Teruru-52/Cubli/pcb/dxf/main_board.dxf

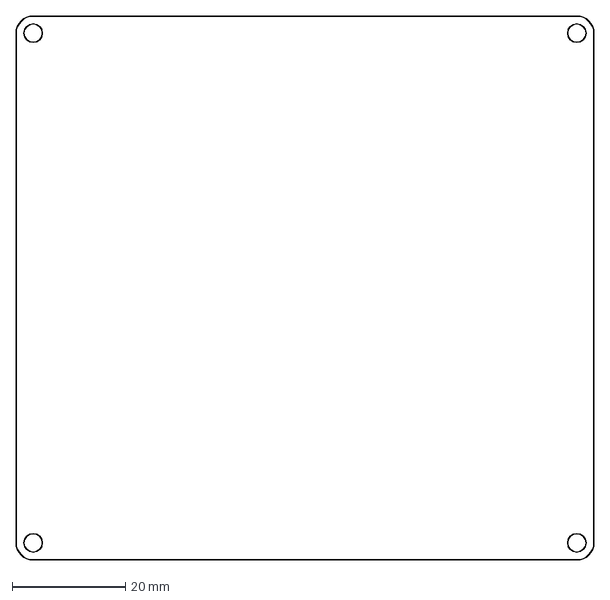
[picture p1: CAD file, 2023-10-04]
pcb/dxf/main_board.dxf
102.0 x 96.0 mm
