Teruru-52/Cubli/pcb/dxf/main_board2.dxf

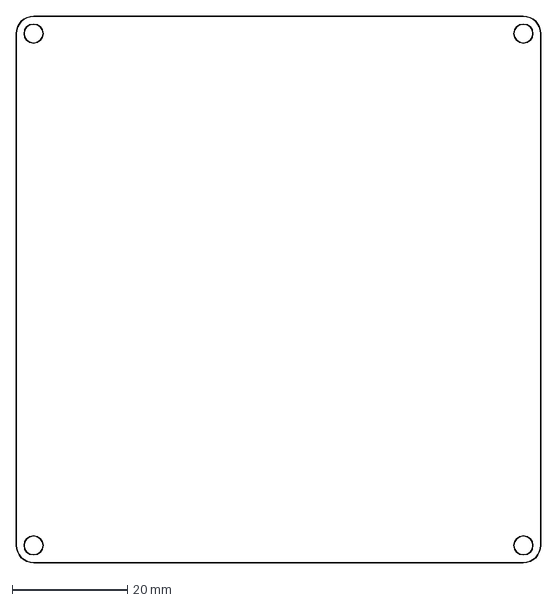
[picture p2: CAD file, 2023-10-04]
pcb/dxf/main_board2.dxf
91.0 x 94.8 mm
