Teruru-52/Cubli/pcb/dxf/lcd.dxf

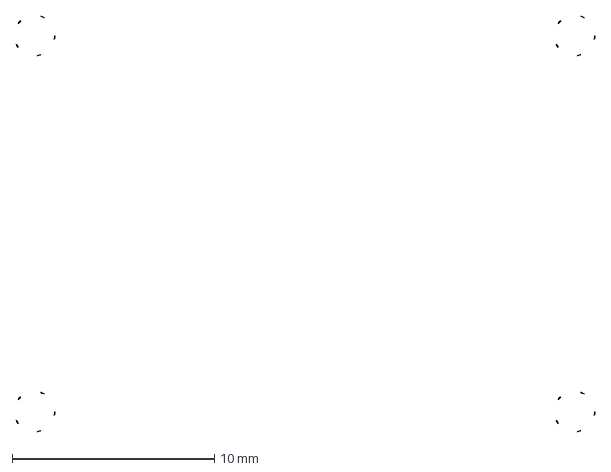
[picture p3: CAD file, 2023-10-04]
pcb/dxf/lcd.dxf
28.6 x 20.5 mm
