Teruru-52/Cubli/pcb/dxf/pdb.dxf

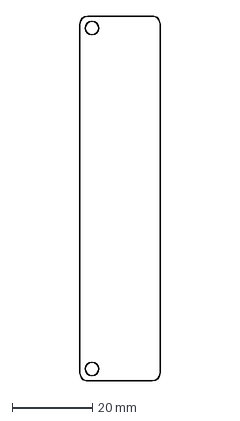
[picture p4: CAD file, 2023-10-04]
pcb/dxf/pdb.dxf
20.0 x 91.0 mm
