Teruru-52/Cubli/pcb/dxf/blmd2.dxf

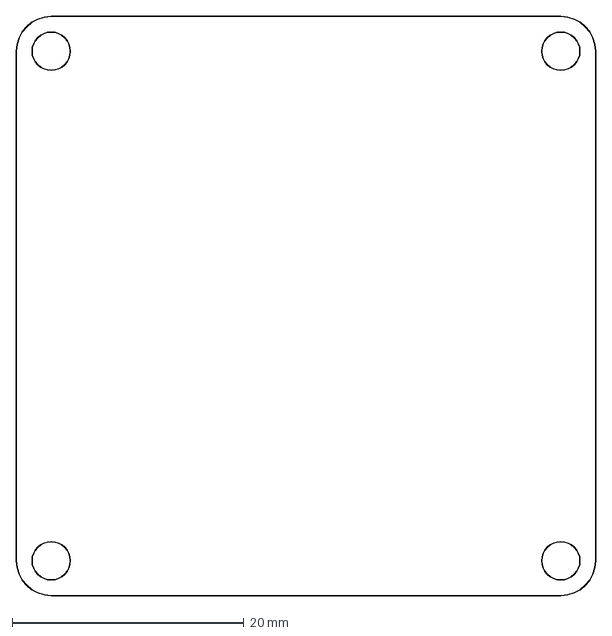
[picture p5: CAD file, 2023-08-15]
pcb/dxf/blmd2.dxf
50.0 x 50.0 mm
