Teruru-52/Cubli/pcb/dxf/blmd.dxf

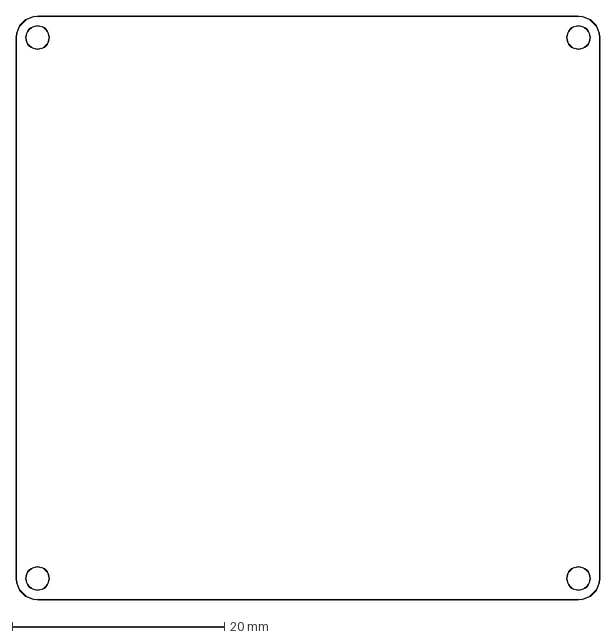
[picture p6: CAD file, 2023-08-14]
pcb/dxf/blmd.dxf
55.0 x 55.0 mm
