Teruru-52/Cubli/pcb/dxf/imu_board.dxf

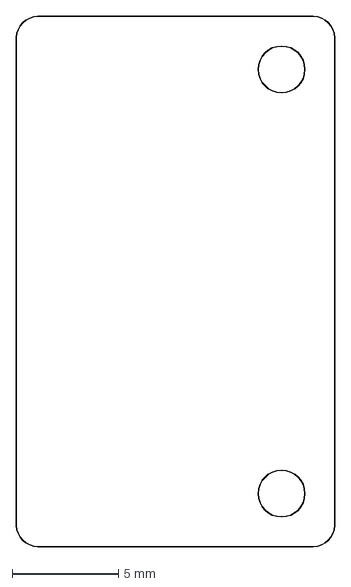
[picture p7: CAD file, 2023-08-14]
pcb/dxf/imu_board.dxf
15.0 x 25.0 mm
