Teruru-52/Cubli/pcb/motor_driver/v1.1/motor_driver-drv8323.pdf

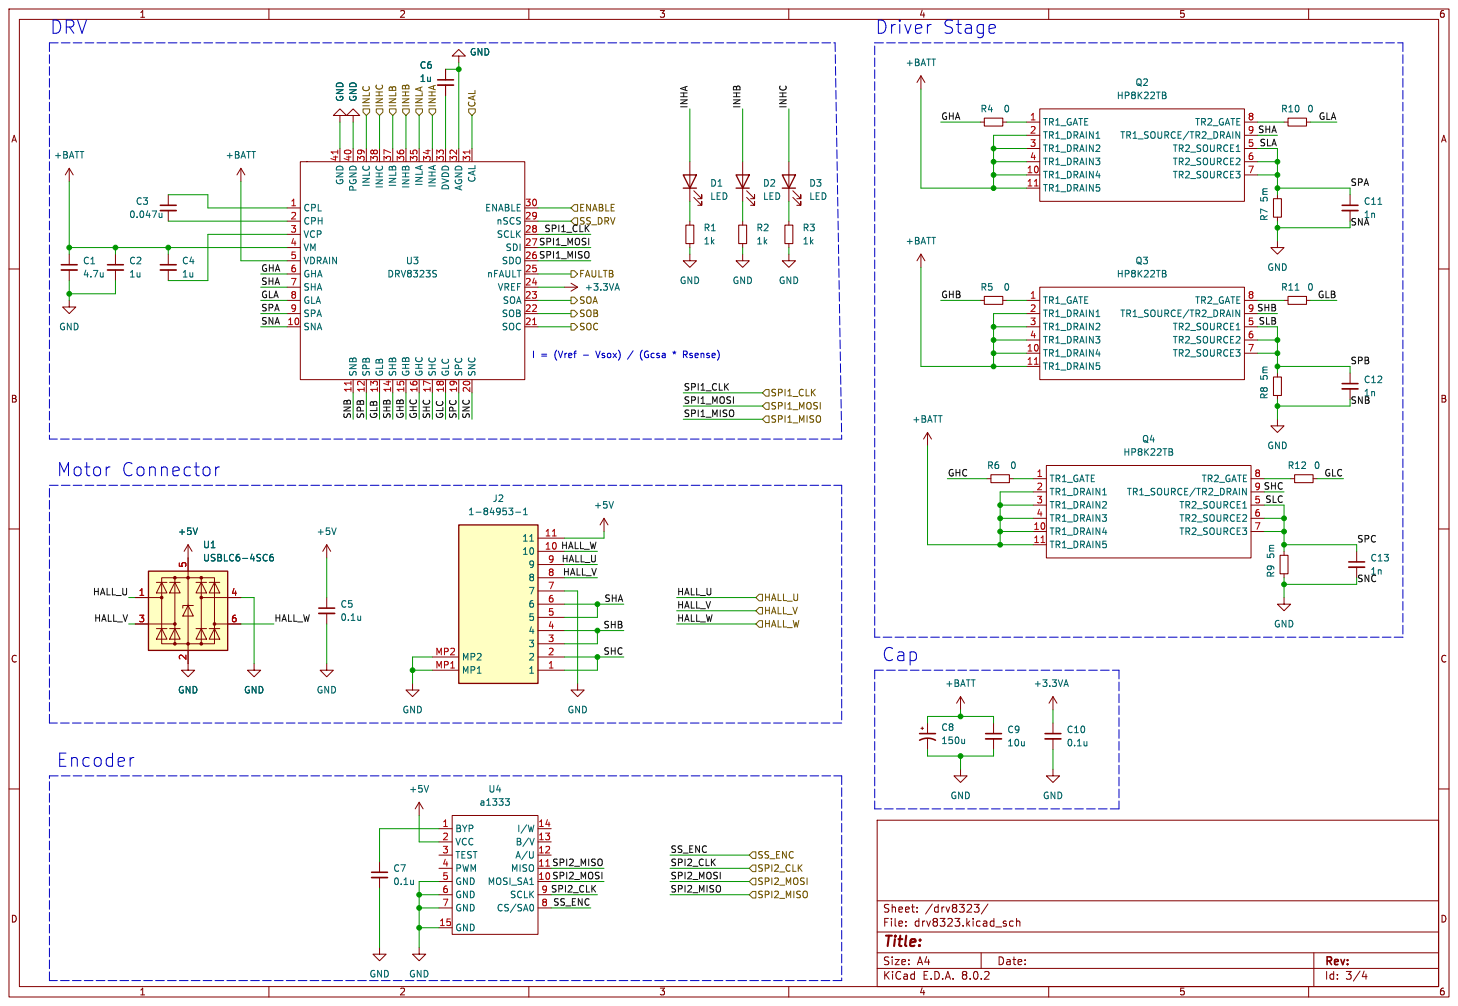
[picture p8: page 1]

SOC INHC INLB INHB

nFAULT 25 SDO 26 SDI 27 SCLK 28

I = (Vref - Vsox) / (Gcsa * Rsense)

Id: 3/4 Title: File: drv8323.kicad_sch Sheet: /drv8323/
