Teruru-52/Cubli/pcb/pdb/pdb.kicad_pcb

## KiCad design pcb/pdb/pdb.kicad_pcb (2024-09-23)

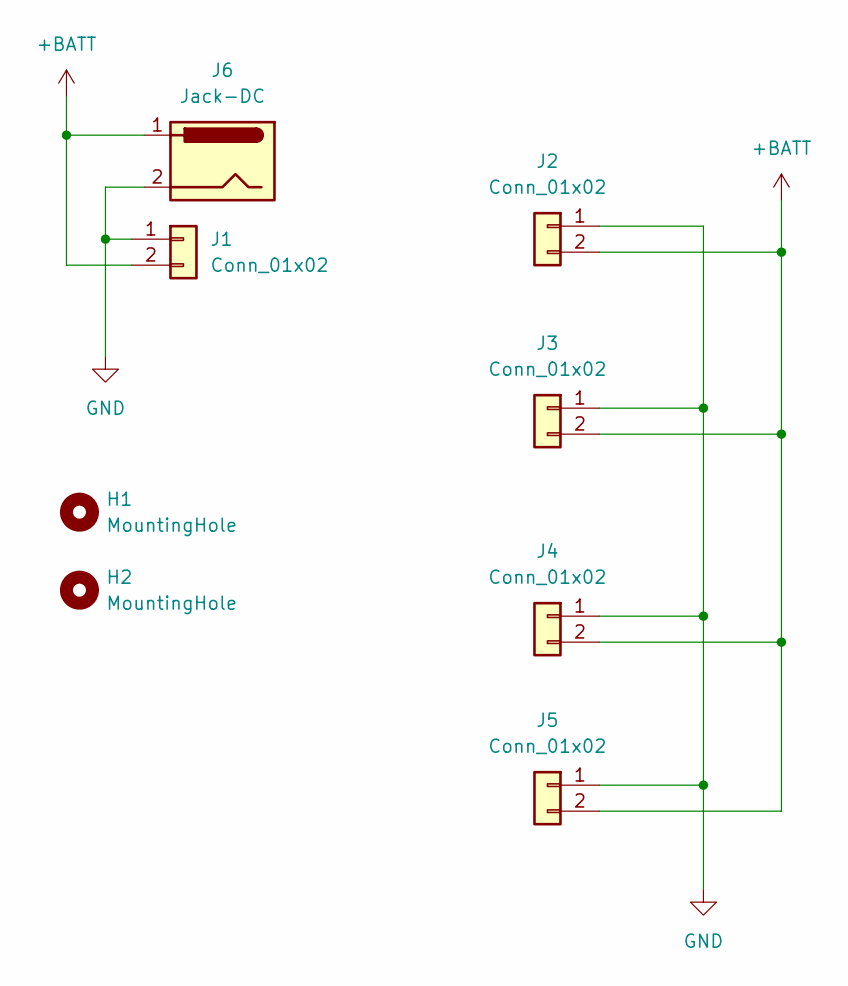
[picture p9: schematic pdb.kicad_sch]

Parts:
H1, H2: MountingHole; MountingHole_3.2mm_M3_Pad_TopBottom
J1, J2, J3, J4, J5: Conn_01x02; AMASS_XT30PW-M_1x02_P2.50mm_Horizontal
J6: Jack-DC; BarrelJack_Horizontal

Connections:
+BATT: J1.2, J2.2, J3.2, J4.2, J5.2, J6.1
GND: J1.1, J2.1, J3.1, J4.1, J5.1, J6.2

Board: 2 copper layers, 8 parts (0 on the bottom side), 2 nets, no tracks yet.
