Teruru-52/Cubli/pcb/motor_driver/v1.2/motor_driver.kicad_pcb

## KiCad design pcb/motor_driver/v1.2/motor_driver.kicad_pcb (2024-09-20)

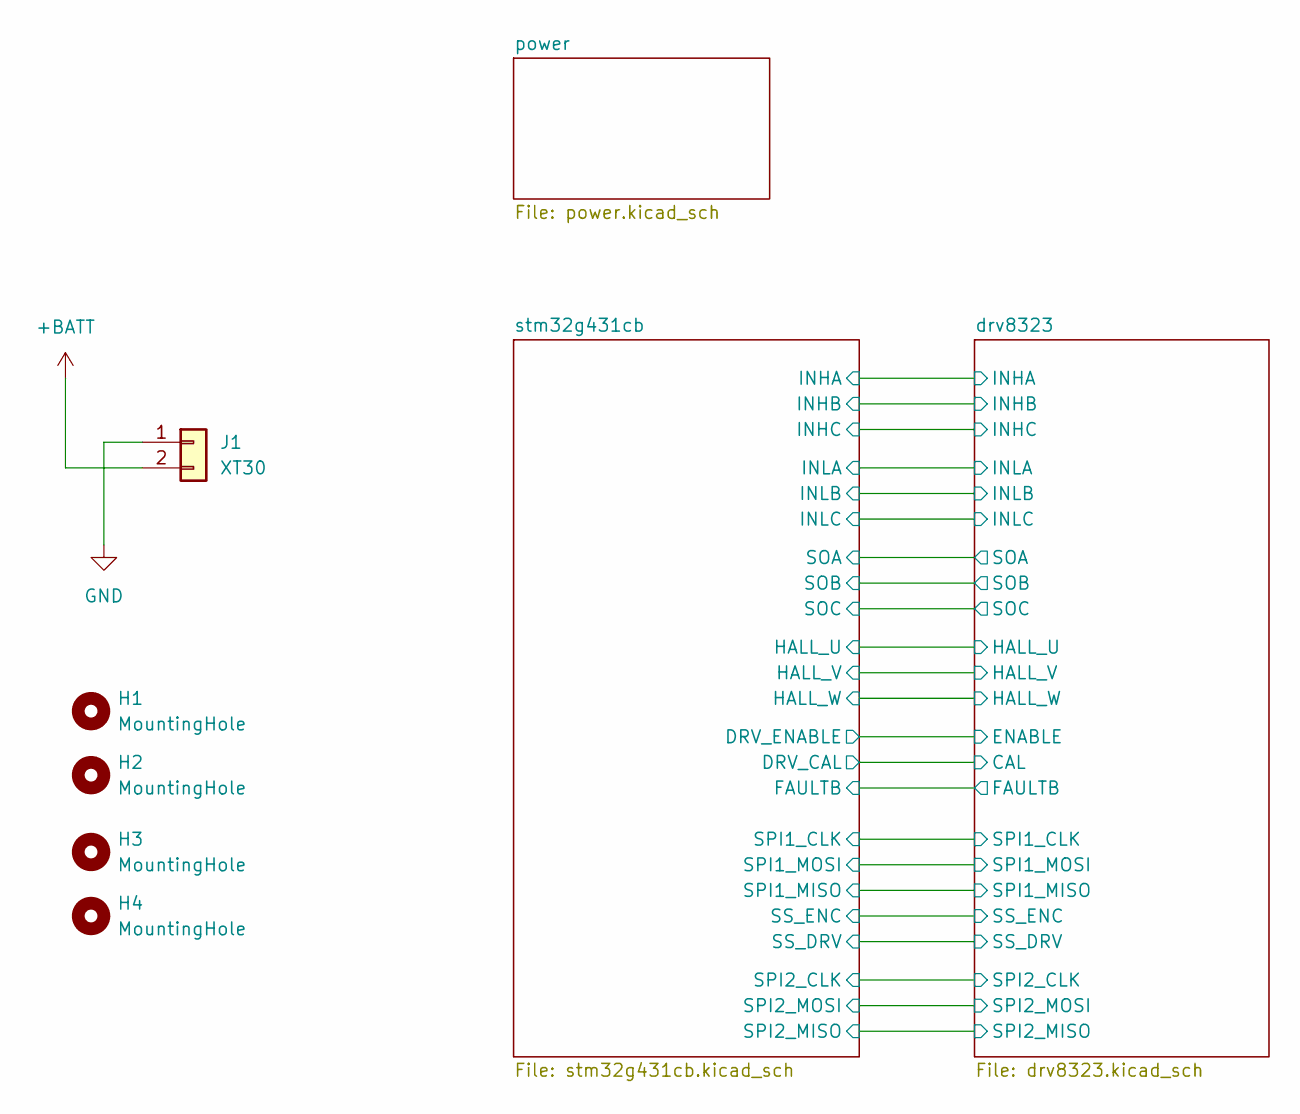
[picture p10: schematic motor_driver.kicad_sch]

Parts:
H1, H2, H3, H4: MountingHole; MountingHole_3.2mm_M3_Pad_TopBottom
J1: XT30; AMASS_XT30U-F_1x02_P5.0mm_Vertical

Connections:
+BATT: J1.2; also elsewhere on the board
GND: J1.1; also elsewhere on the board

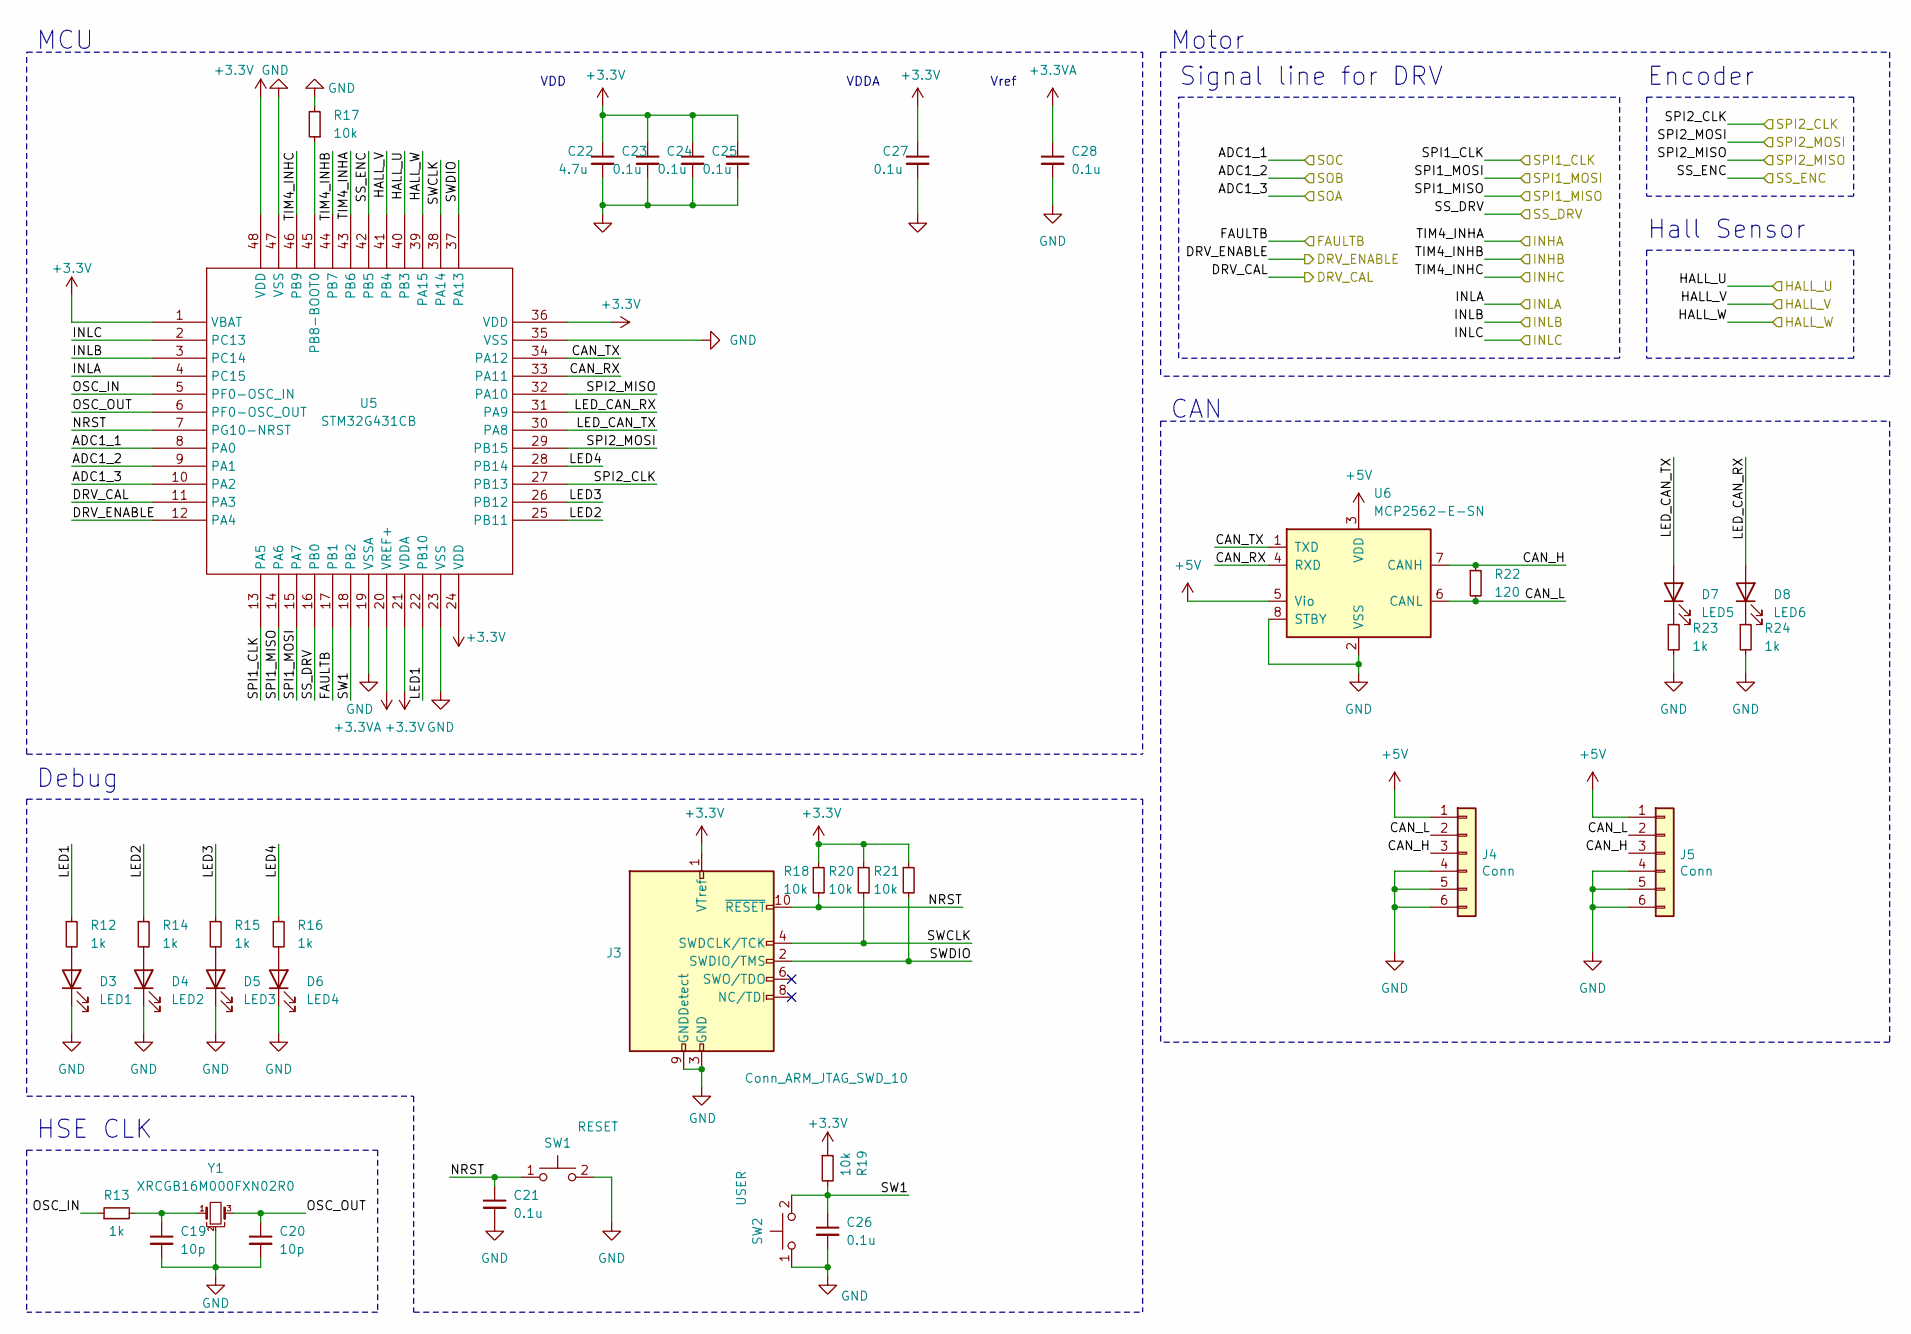
[picture p11: schematic stm32g431cb.kicad_sch]

Parts:
C19, C20: 10p; C_0402_1005Metric_Pad0.74x0.62mm_HandSolder
C21, C26: 0.1u; C_0603_1608Metric_Pad1.08x0.95mm_HandSolder
C22: 4.7u; C_0603_1608Metric
C23, C24, C25, C27, C28: 0.1u; C_0603_1608Metric
D3: LED1; LED_0603_1608Metric
D4: LED2; LED_0603_1608Metric
D5: LED3; LED_0603_1608Metric
D6: LED4; LED_0603_1608Metric
D7: LED5; LED_0603_1608Metric
D8: LED6; LED_0603_1608Metric
J3: Conn_ARM_JTAG_SWD_10; 322110010000
J4, J5: Conn; 21322604YY
R12, R14, R15, R16, R23, R24: 1k; R_0603_1608Metric_Pad0.98x0.95mm_HandSolder
R13: 1k; R_0402_1005Metric_Pad0.72x0.64mm_HandSolder
R17, R18, R19, R20, R21: 10k; R_0603_1608Metric_Pad0.98x0.95mm_HandSolder
R22: 120; R_0603_1608Metric_Pad0.98x0.95mm_HandSolder
SW1: RESET; TVAF06-A020B-R
SW2: USER; TVAF06-A020B-R
U5: STM32G431CB; LQFP-48_7x7mm_P0.5mm
U6: MCP2562-E-SN; SOIC-8_3.9x4.9mm_P1.27mm
Y1: XRCGB16M000FXN02R0

Connections:
+3.3V: C22.1, C23.1, C24.1, C25.1, C27.1, J3.1 (VTref), R18.1, R19.1, R20.1, R21.1, U5.1 (VBAT), U5.21 (VDDA), U5.24 (VDD), U5.36 (VDD), U5.48 (VDD); also elsewhere on the board
+3.3VA: C28.1, U5.20 (VREF+); also elsewhere on the board
+5V: J4.1, J5.1, U6.3 (VDD), U6.5 (Vio); also elsewhere on the board
/drv8323/HALL_U: U5.40 (PB3); also elsewhere on the board
/drv8323/HALL_V: U5.41 (PB4); also elsewhere on the board
/drv8323/HALL_W: U5.39 (PA15); also elsewhere on the board
/drv8323/SPI1_CLK: U5.13 (PA5); also elsewhere on the board
/drv8323/SPI1_MISO: U5.14 (PA6); also elsewhere on the board
/drv8323/SPI1_MOSI: U5.15 (PA7); also elsewhere on the board
/drv8323/SPI2_CLK: U5.27 (PB13); also elsewhere on the board
/drv8323/SPI2_MISO: U5.32 (PA10); also elsewhere on the board
/drv8323/SPI2_MOSI: U5.29 (PB15); also elsewhere on the board
/drv8323/SS_ENC: U5.42 (PB5); also elsewhere on the board
/stm32g431cb/ADC1_1: U5.8 (PA0); also elsewhere on the board
/stm32g431cb/ADC1_2: U5.9 (PA1); also elsewhere on the board
/stm32g431cb/ADC1_3: U5.10 (PA2); also elsewhere on the board
/stm32g431cb/CAN_H: J4.3, J5.3, R22.1, U6.7 (CANH)
/stm32g431cb/CAN_L: J4.2, J5.2, R22.2, U6.6 (CANL)
/stm32g431cb/CAN_RX: U5.33 (PA11), U6.4 (RXD)
/stm32g431cb/CAN_TX: U5.34 (PA12), U6.1 (TXD)
/stm32g431cb/DRV_CAL: U5.11 (PA3); also elsewhere on the board
/stm32g431cb/DRV_ENABLE: U5.12 (PA4); also elsewhere on the board
/stm32g431cb/FAULTB: U5.17 (PB1); also elsewhere on the board
/stm32g431cb/INLA: U5.4 (PC15); also elsewhere on the board
/stm32g431cb/INLB: U5.3 (PC14); also elsewhere on the board
/stm32g431cb/INLC: U5.2 (PC13); also elsewhere on the board
/stm32g431cb/LED1: R12.1, U5.22 (PB10)
/stm32g431cb/LED2: R14.1, U5.25 (PB11)
/stm32g431cb/LED3: R15.1, U5.26 (PB12)
/stm32g431cb/LED4: R16.1, U5.28 (PB14)
/stm32g431cb/LED_CAN_RX: D8.2 (A), U5.31 (PA9)
/stm32g431cb/LED_CAN_TX: D7.2 (A), U5.30 (PA8)
/stm32g431cb/NRST: C21.1, J3.10 (~RESET), R18.2, SW1.1, U5.7 (PG10-NRST)
/stm32g431cb/OSC_IN: R13.1, U5.5 (PF0-OSC_IN)
/stm32g431cb/OSC_OUT: C20.1, U5.6 (PF0-OSC_OUT), Y1.3
/stm32g431cb/SS_DRV: U5.16 (PB0); also elsewhere on the board
/stm32g431cb/SW1: C26.1, R19.2, SW2.2, U5.18 (PB2)
/stm32g431cb/SWCLK: J3.4 (SWDCLK/TCK), R20.2, U5.38 (PA14)
/stm32g431cb/SWDIO: J3.2 (SWDIO/TMS), R21.2, U5.37 (PA13)
/stm32g431cb/TIM4_INHA: U5.43 (PB6); also elsewhere on the board
/stm32g431cb/TIM4_INHB: U5.44 (PB7); also elsewhere on the board
/stm32g431cb/TIM4_INHC: U5.46 (PB9); also elsewhere on the board
GND: C19.2, C20.2, C21.2, C22.2, C23.2, C24.2, C25.2, C26.2, C27.2, C28.2, D3.1 (K), D4.1 (K), D5.1 (K), D6.1 (K), J3.3 (GND), J3.5 (GND), J3.9 (GNDDetect), J4.4, J4.5, J4.6, J5.4, J5.5, J5.6, R17.2, R23.2, R24.2, SW1.2, SW2.1, U5.19 (VSSA), U5.23 (VSS), U5.35 (VSS), U5.47 (VSS), U6.2 (VSS), U6.8 (STBY), Y1.2; also elsewhere on the board
unnamed: C19.1, R13.2, Y1.1
unnamed: D3.2 (A), R12.2
unnamed: D4.2 (A), R14.2
unnamed: D5.2 (A), R15.2
unnamed: D6.2 (A), R16.2
unnamed: D7.1 (K), R23.1
unnamed: D8.1 (K), R24.1
unnamed: R17.1, U5.45 (PB8-BOOT0)

Notes on the sheet:
Motor
HSE CLK
MCU
CAN
Encoder
Signal line for DRV
Debug
VDD
Vref
VDDA
Hall Sensor

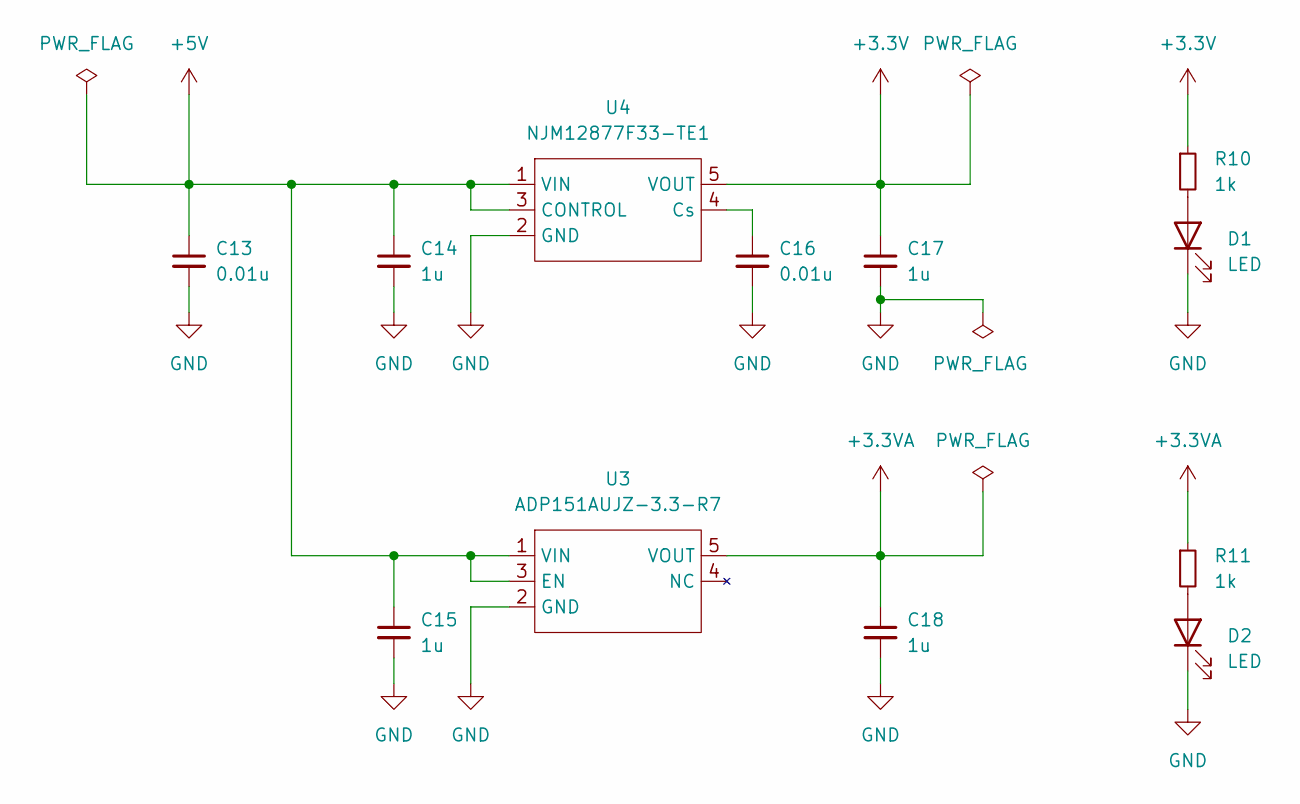
[picture p12: schematic power.kicad_sch]

Parts:
C13, C16: 0.01u; C_0603_1608Metric_Pad1.08x0.95mm_HandSolder
C14, C15, C17, C18: 1u; C_0603_1608Metric_Pad1.08x0.95mm_HandSolder
D1, D2: LED; LED_0603_1608Metric
R10, R11: 1k; R_0603_1608Metric_Pad0.98x0.95mm_HandSolder
U3: ADP151AUJZ-3.3-R7; SOT-23-5_HandSoldering
U4: NJM12877F33-TE1; SOT-23-5_HandSoldering

Connections:
+3.3V: C17.1, R10.1, U4.5 (VOUT); also elsewhere on the board
+3.3VA: C18.1, R11.1, U3.5 (VOUT); also elsewhere on the board
+5V: C13.1, C14.1, C15.1, U3.1 (VIN), U3.3 (EN), U4.1 (VIN), U4.3 (CONTROL); also elsewhere on the board
GND: C13.2, C14.2, C15.2, C16.2, C17.2, C18.2, D1.1 (K), D2.1 (K), U3.2 (GND), U4.2 (GND); also elsewhere on the board
unnamed: D1.2 (A), R10.2
unnamed: D2.2 (A), R11.2
unnamed: C16.1, U4.4 (Cs)

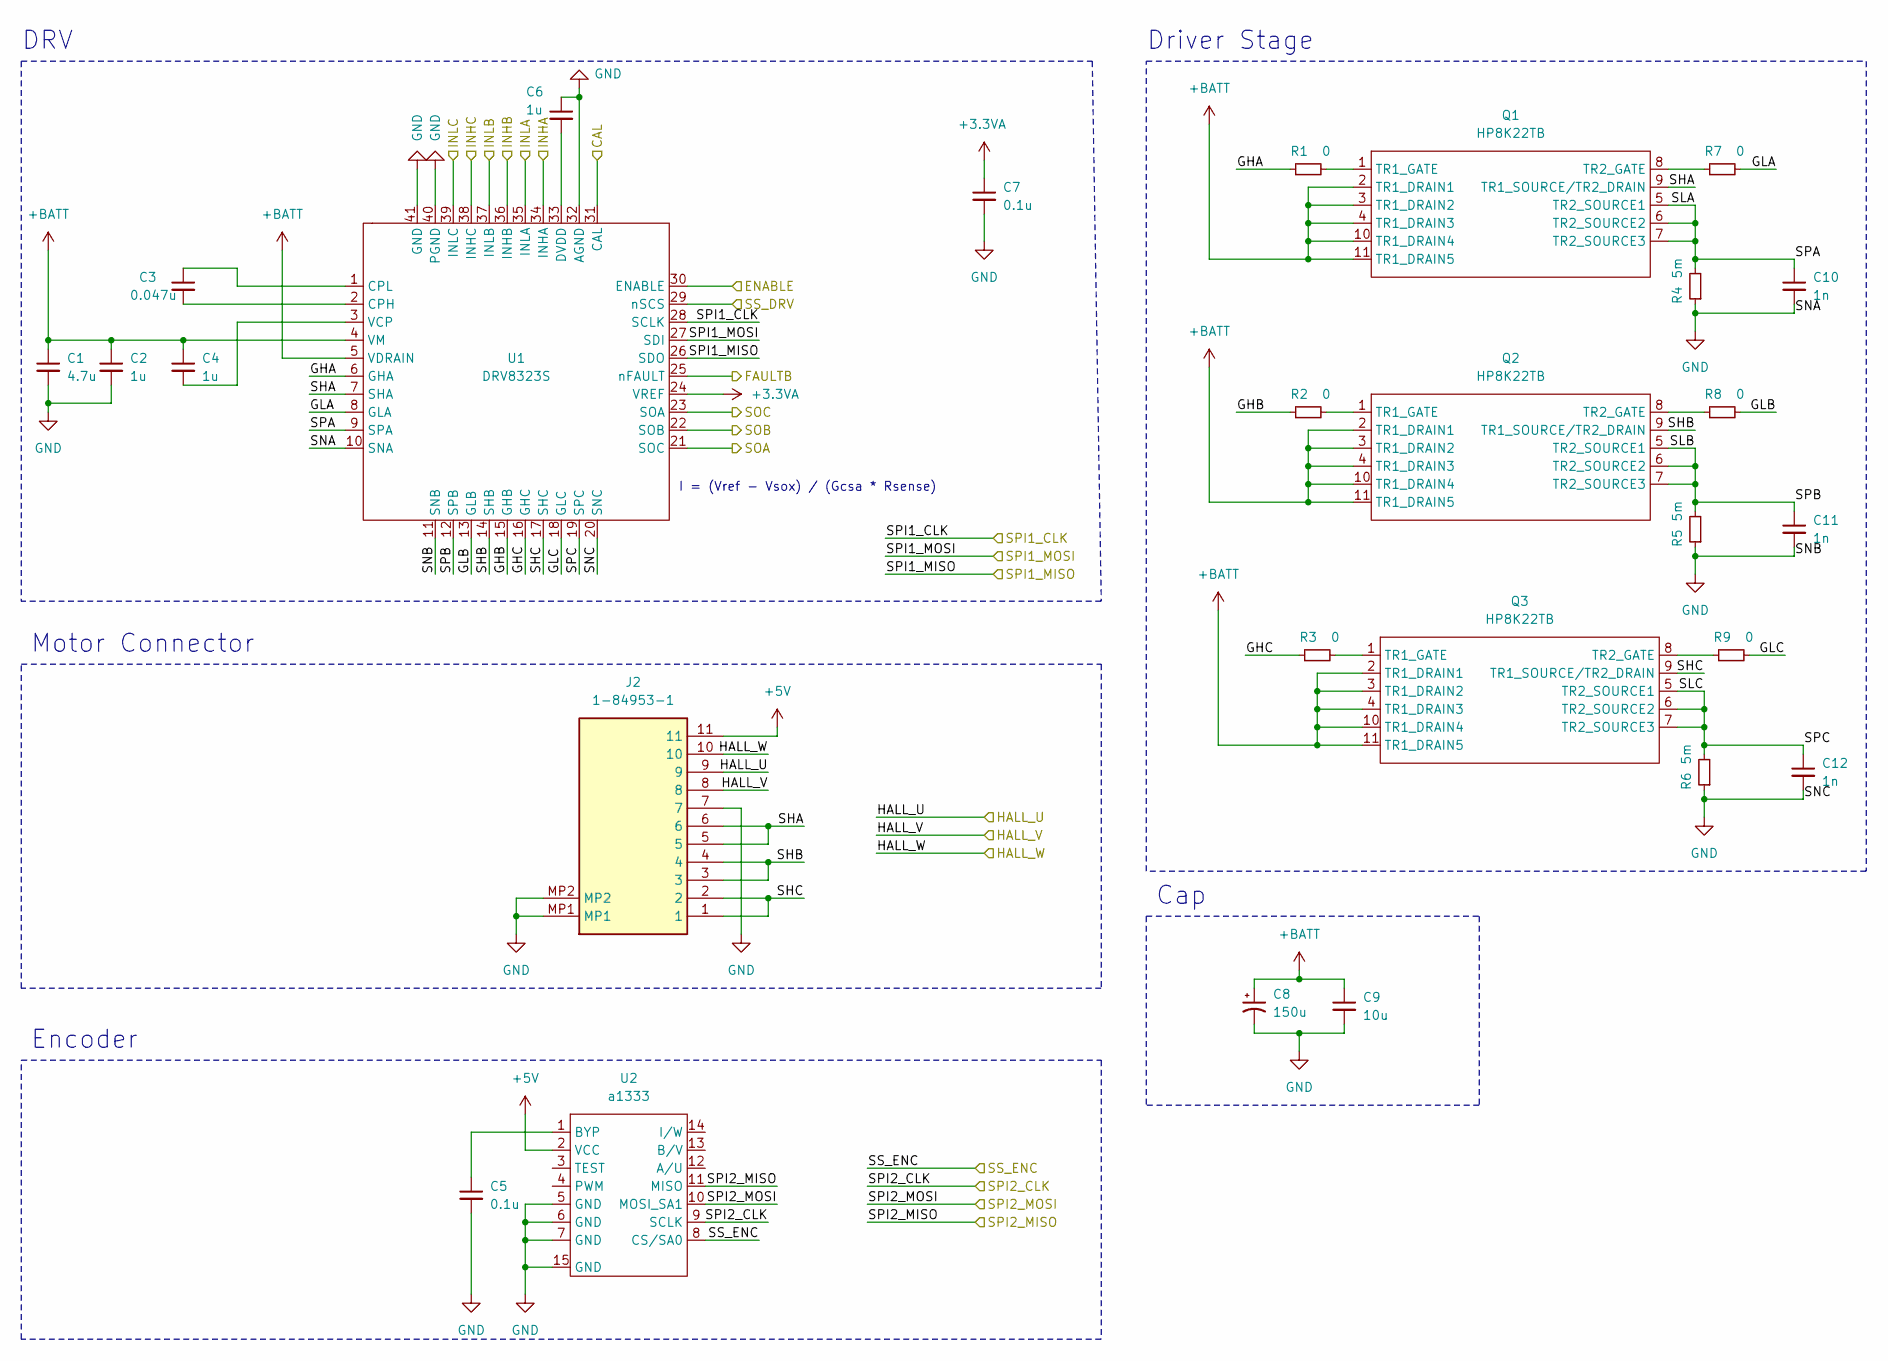
[picture p13: schematic drv8323.kicad_sch]

Parts:
C1: 4.7u; C_0603_1608Metric_Pad1.08x0.95mm_HandSolder
C2, C4, C6: 1u; C_0603_1608Metric_Pad1.08x0.95mm_HandSolder
C3: 0.047u; C_0603_1608Metric_Pad1.08x0.95mm_HandSolder
C5: 0.1u; C_0603_1608Metric_Pad1.08x0.95mm_HandSolder
C7: 0.1u; C_0402_1005Metric_Pad0.74x0.62mm_HandSolder
C8: 150u; CP_Elec_6.3x3.9
C9: 10u; C_0603_1608Metric_Pad1.08x0.95mm_HandSolder
C10, C11, C12: 1n; C_0402_1005Metric_Pad0.74x0.62mm_HandSolder
J2: 1-84953-1; Manufacturer_Part_Number 1-84953-1; Mouser Part Number 571-1-84953-1
Q1, Q2, Q3: HP8K22TB; HP8K24TB
R1, R2, R3, R7, R8, R9: 0; R_0805_2012Metric_Pad1.20x1.40mm_HandSolder
R4, R5, R6: 5m; R_2010_5025Metric_Pad1.40x2.65mm_HandSolder
U1: DRV8323S; QFN-40-1EP_6x6mm_P0.5mm_EP4.6x4.6mm
U2: a1333; HTSSOP-14-1EP_4.4x5mm_P0.65mm_EP3.4x5mm_Mask3x3.1mm

Connections:
+3.3VA: C7.1, U1.24 (VREF); also elsewhere on the board
+5V: J2.11, U2.2 (VCC); also elsewhere on the board
+BATT: C1.1, C2.1, C4.1, C8.1, C9.1, Q1.2 (TR1_DRAIN1), Q1.3 (TR1_DRAIN2), Q1.4 (TR1_DRAIN3), Q1.10 (TR1_DRAIN4), Q1.11 (TR1_DRAIN5), Q2.2 (TR1_DRAIN1), Q2.3 (TR1_DRAIN2), Q2.4 (TR1_DRAIN3), Q2.10 (TR1_DRAIN4), Q2.11 (TR1_DRAIN5), Q3.2 (TR1_DRAIN1), Q3.3 (TR1_DRAIN2), Q3.4 (TR1_DRAIN3), Q3.10 (TR1_DRAIN4), Q3.11 (TR1_DRAIN5), U1.4 (VM), U1.5 (VDRAIN); also elsewhere on the board
/drv8323/GHA: R1.1, U1.6 (GHA)
/drv8323/GHB: R2.1, U1.15 (GHB)
/drv8323/GHC: R3.1, U1.16 (GHC)
/drv8323/GLA: R7.2, U1.8 (GLA)
/drv8323/GLB: R8.2, U1.13 (GLB)
/drv8323/GLC: R9.2, U1.18 (GLC)
/drv8323/HALL_U: J2.9; also elsewhere on the board
/drv8323/HALL_V: J2.8; also elsewhere on the board
/drv8323/HALL_W: J2.10; also elsewhere on the board
/drv8323/SHA: J2.5, J2.6, Q1.9 (TR1_SOURCE/TR2_DRAIN), U1.7 (SHA)
/drv8323/SHB: J2.3, J2.4, Q2.9 (TR1_SOURCE/TR2_DRAIN), U1.14 (SHB)
/drv8323/SHC: J2.1, J2.2, Q3.9 (TR1_SOURCE/TR2_DRAIN), U1.17 (SHC)
/drv8323/SLA: C10.1, Q1.5 (TR2_SOURCE1), Q1.6 (TR2_SOURCE2), Q1.7 (TR2_SOURCE3), R4.2, U1.9 (SPA)
/drv8323/SLB: C11.1, Q2.5 (TR2_SOURCE1), Q2.6 (TR2_SOURCE2), Q2.7 (TR2_SOURCE3), R5.2, U1.12 (SPB)
/drv8323/SLC: C12.1, Q3.5 (TR2_SOURCE1), Q3.6 (TR2_SOURCE2), Q3.7 (TR2_SOURCE3), R6.2, U1.19 (SPC)
/drv8323/SPI1_CLK: U1.28 (SCLK); also elsewhere on the board
/drv8323/SPI1_MISO: U1.26 (SDO); also elsewhere on the board
/drv8323/SPI1_MOSI: U1.27 (SDI); also elsewhere on the board
/drv8323/SPI2_CLK: U2.9 (SCLK); also elsewhere on the board
/drv8323/SPI2_MISO: U2.11 (MISO); also elsewhere on the board
/drv8323/SPI2_MOSI: U2.10 (MOSI_SA1); also elsewhere on the board
/drv8323/SS_ENC: U2.8 (CS/SA0); also elsewhere on the board
/stm32g431cb/ADC1_1: U1.23 (SOA); also elsewhere on the board
/stm32g431cb/ADC1_2: U1.22 (SOB); also elsewhere on the board
/stm32g431cb/ADC1_3: U1.21 (SOC); also elsewhere on the board
/stm32g431cb/DRV_CAL: U1.31 (CAL); also elsewhere on the board
/stm32g431cb/DRV_ENABLE: U1.30 (ENABLE); also elsewhere on the board
/stm32g431cb/FAULTB: U1.25 (nFAULT); also elsewhere on the board
/stm32g431cb/INLA: U1.35 (INLA); also elsewhere on the board
/stm32g431cb/INLB: U1.37 (INLB); also elsewhere on the board
/stm32g431cb/INLC: U1.39 (INLC); also elsewhere on the board
/stm32g431cb/SS_DRV: U1.29 (nSCS); also elsewhere on the board
/stm32g431cb/TIM4_INHA: U1.34 (INHA); also elsewhere on the board
/stm32g431cb/TIM4_INHB: U1.36 (INHB); also elsewhere on the board
/stm32g431cb/TIM4_INHC: U1.38 (INHC); also elsewhere on the board
GND: C1.2, C2.2, C5.2, C6.1, C7.2, C8.2, C9.2, C10.2, C11.2, C12.2, J2.7, J2.MP1, J2.MP2, R4.1, R5.1, R6.1, U1.10 (SNA), U1.11 (SNB), U1.20 (SNC), U1.32 (AGND), U1.40 (PGND), U1.41 (GND), U2.5 (GND), U2.6 (GND), U2.7 (GND), U2.15 (GND); also elsewhere on the board
unnamed: Q1.1 (TR1_GATE), R1.2
unnamed: Q1.8 (TR2_GATE), R7.1
unnamed: Q2.1 (TR1_GATE), R2.2
unnamed: Q2.8 (TR2_GATE), R8.1
unnamed: Q3.1 (TR1_GATE), R3.2
unnamed: Q3.8 (TR2_GATE), R9.1
unnamed: C3.2, U1.2 (CPH)
unnamed: C3.1, U1.1 (CPL)
unnamed: C6.2, U1.33 (DVDD)
unnamed: C4.2, U1.3 (VCP)
unnamed: C5.1, U2.1 (BYP)

Notes on the sheet:
Driver Stage
DRV
Motor Connector
Cap
Encoder
I = (Vref - Vsox) / (Gcsa * Rsense)

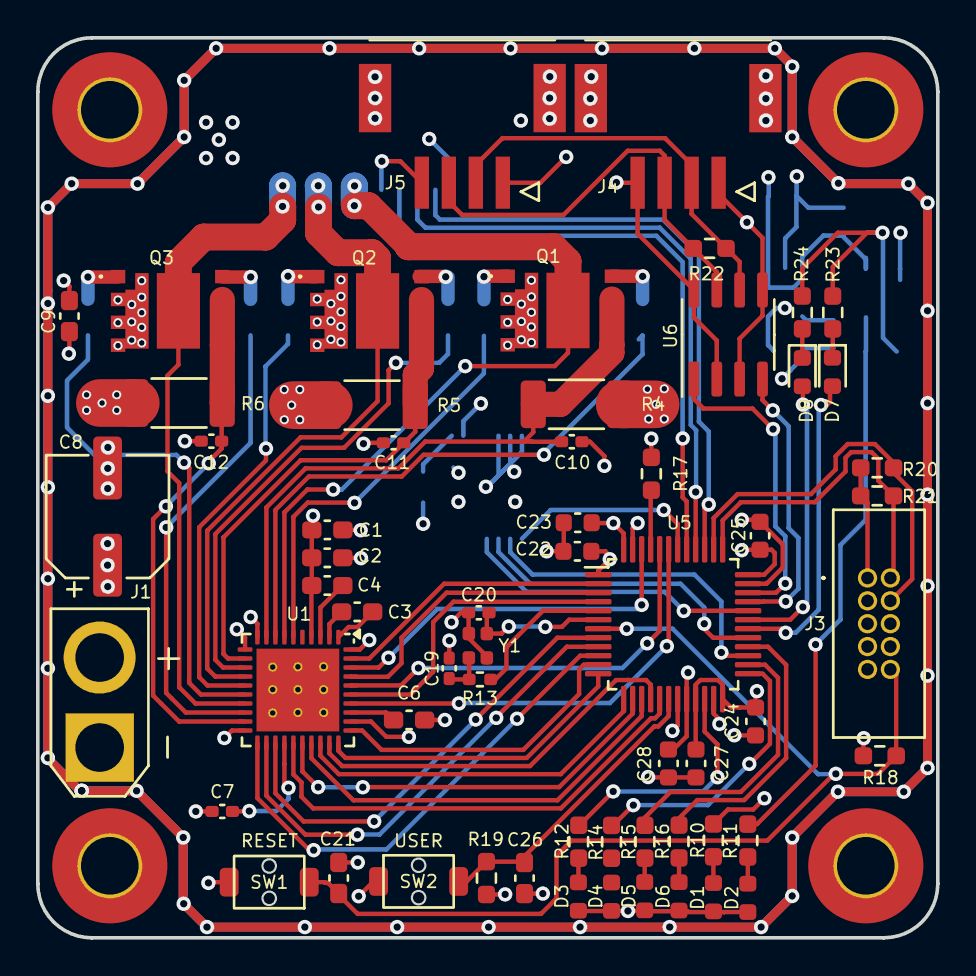
[picture p14: board pcb/motor_driver/v1.2/motor_driver.kicad_pcb from above]

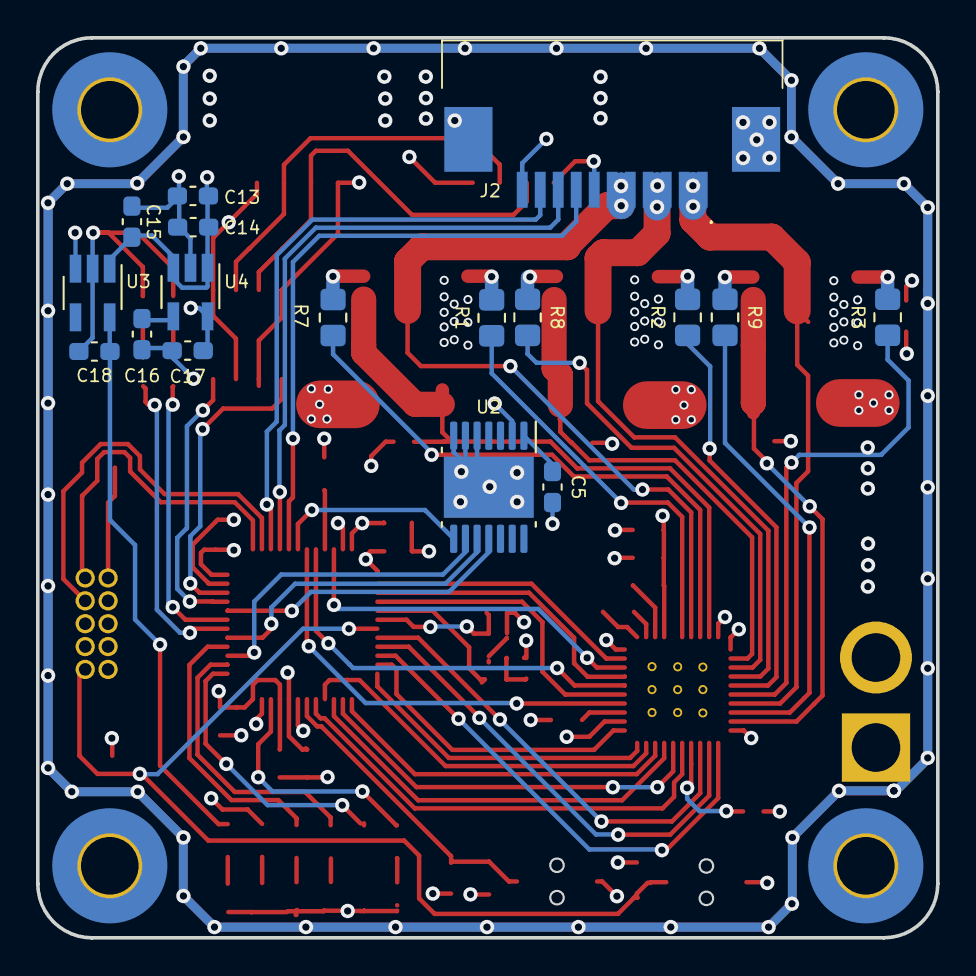
[picture p15: board pcb/motor_driver/v1.2/motor_driver.kicad_pcb from below]

Board: 4 copper layers, 50.0 x 50.0 mm, 81 parts (17 on the bottom side), 78 nets.
