Teruru-52/Cubli/pcb/main/main.kicad_pcb

## KiCad design pcb/main/main.kicad_pcb (2024-08-14)

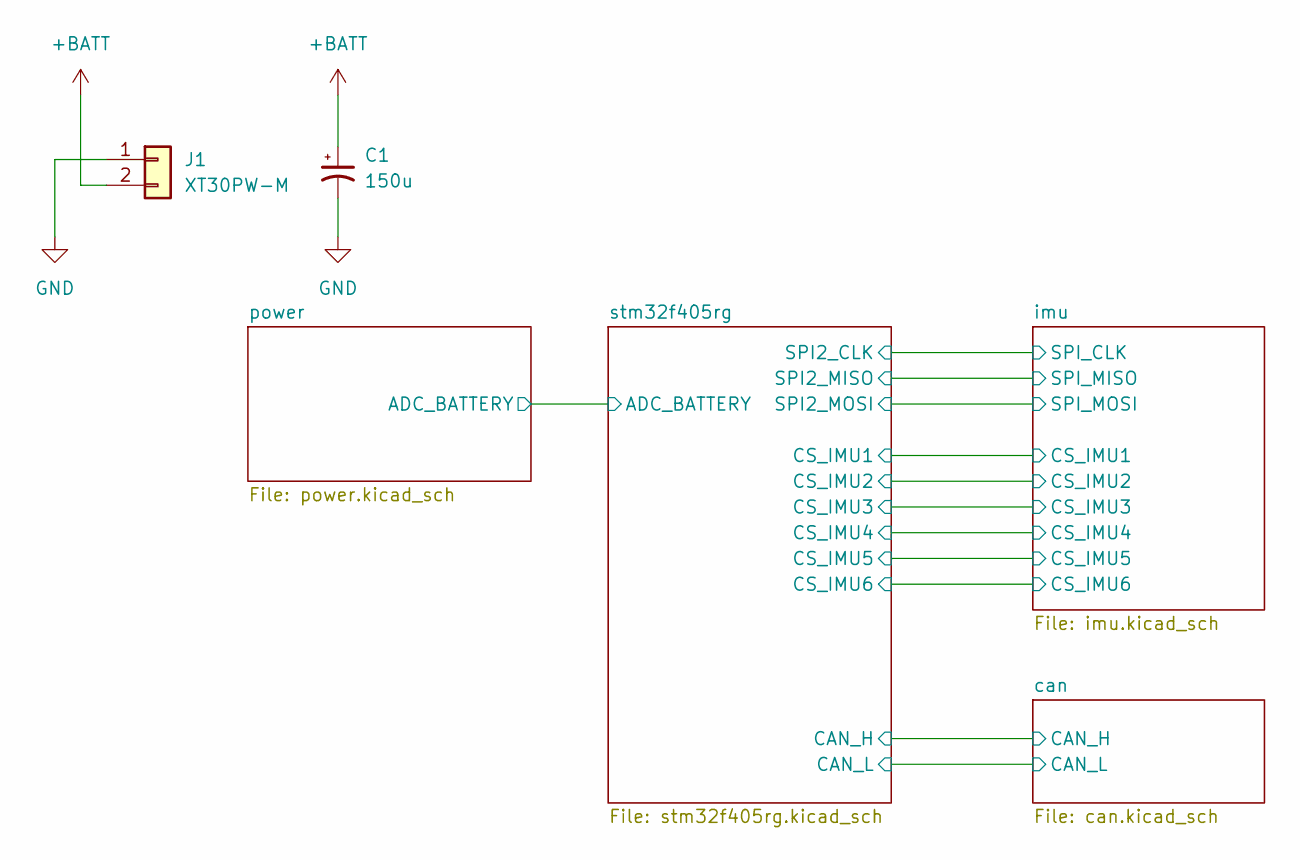
[picture p16: schematic main.kicad_sch]

Parts:
C1: 150u; CP_Elec_8x10.5
J1: XT30PW-M; AMASS_XT30PW-M_1x02_P2.50mm_Horizontal

Connections:
+BATT: C1.1, J1.2; also elsewhere on the board
GND: C1.2, J1.1; also elsewhere on the board

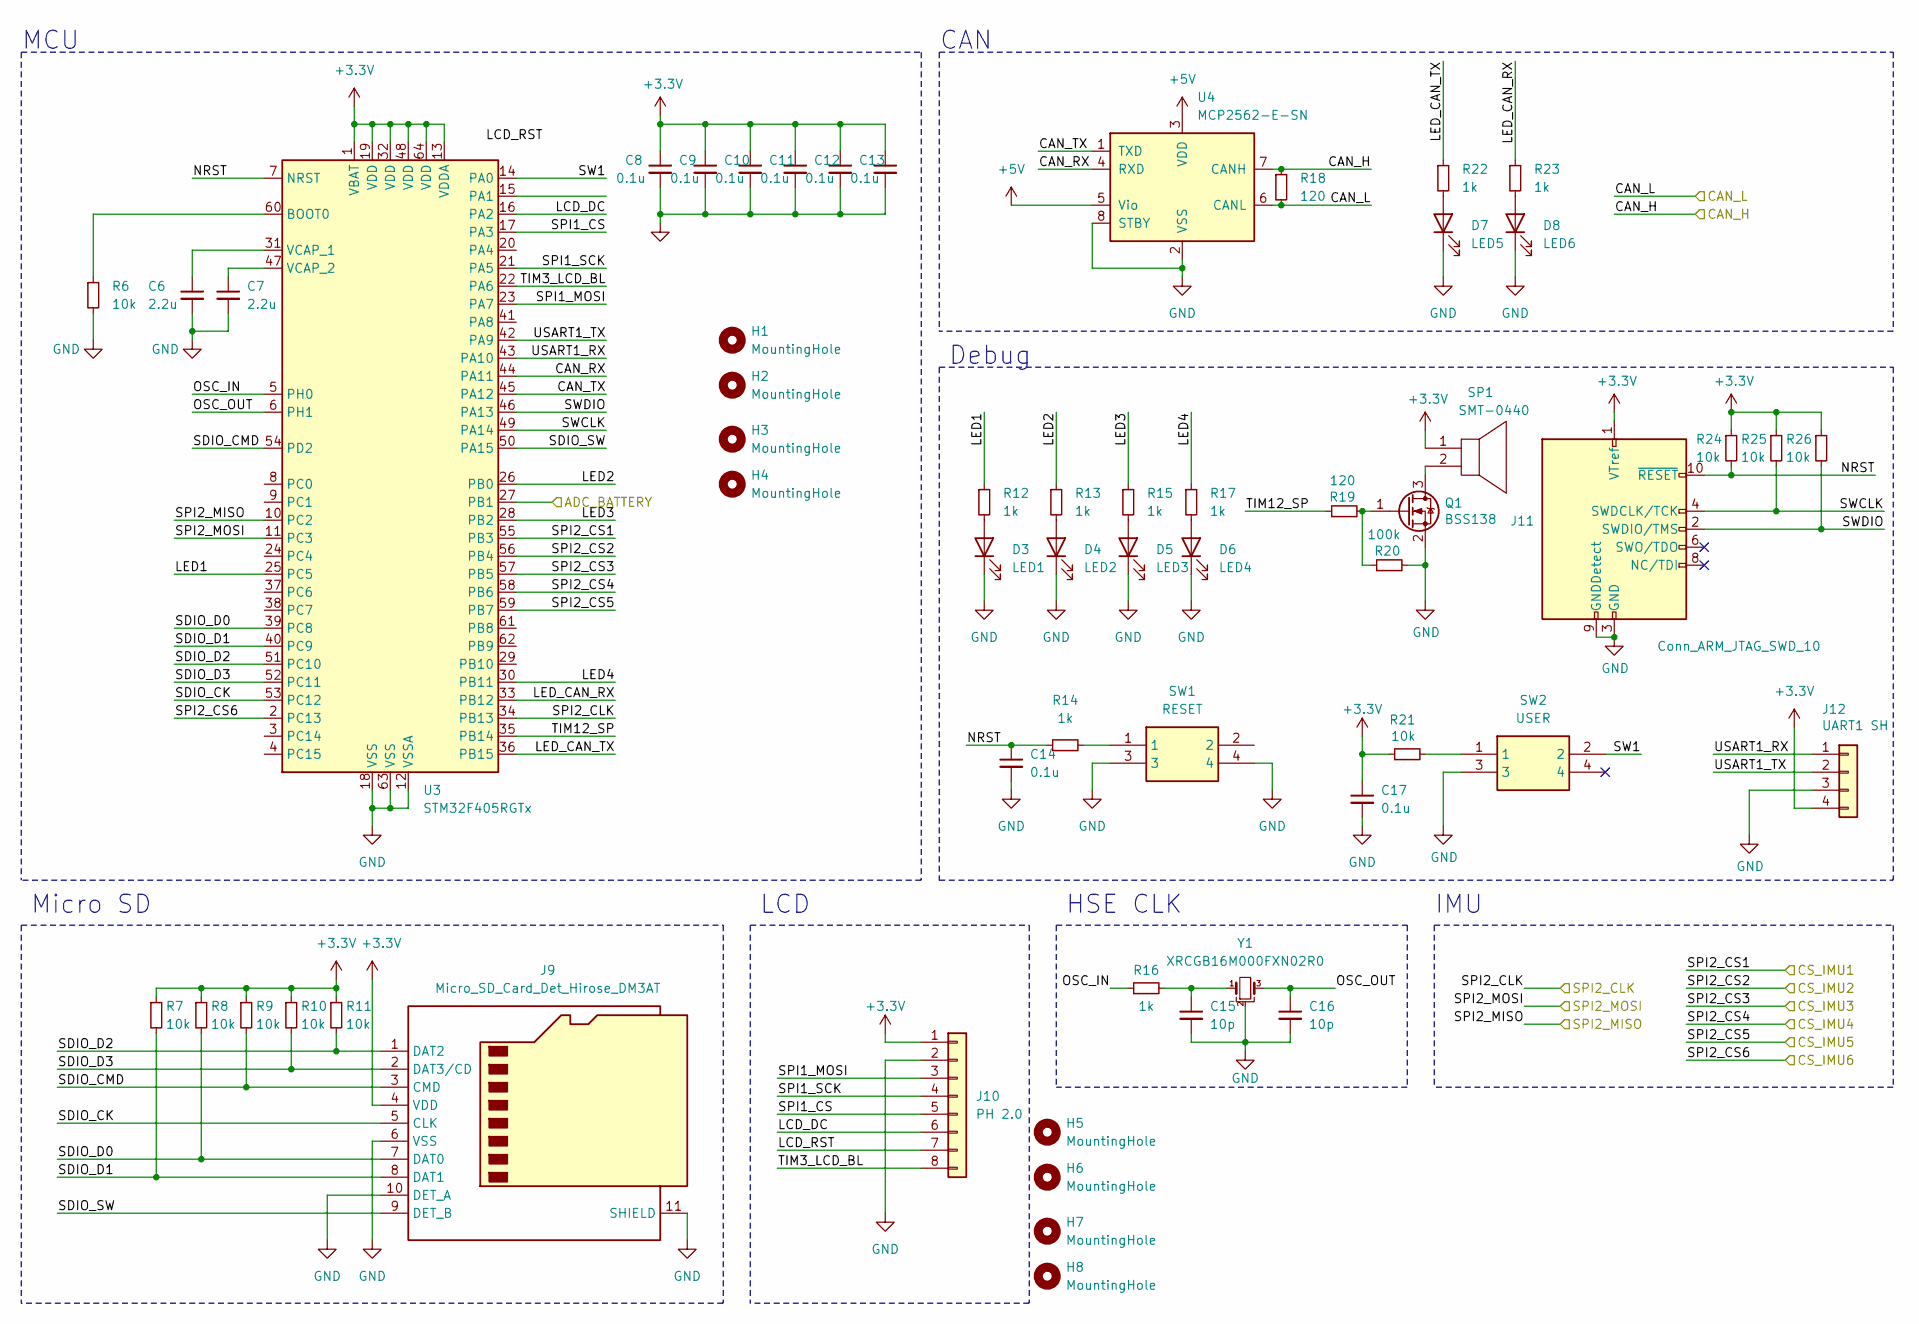
[picture p17: schematic stm32f405rg.kicad_sch]

Parts:
C6, C7: 2.2u; C_0603_1608Metric_Pad1.08x0.95mm_HandSolder
C8, C9, C10, C11, C12, C13, C14, C17: 0.1u; C_0603_1608Metric_Pad1.08x0.95mm_HandSolder
C15, C16: 10p; C_0402_1005Metric_Pad0.74x0.62mm_HandSolder
D3: LED1; LED_0603_1608Metric
D4: LED2; LED_0603_1608Metric
D5: LED3; LED_0603_1608Metric
D6: LED4; LED_0603_1608Metric
D7: LED5; LED_0603_1608Metric
D8: LED6; LED_0603_1608Metric
H1, H2, H3, H4: MountingHole; MountingHole_3.2mm_M3_Pad_TopBottom
H5, H6, H7, H8: MountingHole; MountingHole_2.2mm_M2_ISO14580_Pad
J9: Micro_SD_Card_Det_Hirose_DM3AT; microSD_HC_Hirose_DM3AT-SF-PEJM5
J10: PH 2.0; JST_PH_S8B-PH-SM4-TB_1x08-1MP_P2.00mm_Horizontal
J11: Conn_ARM_JTAG_SWD_10; 322110010000
J12: UART1 SH; PinHeader_1x04_P2.54mm_Vertical
Q1: BSS138; SOT-23
R6: 10k; R_0603_1608Metric
R7, R8, R9, R10, R11, R21, R24, R25, R26: 10k; R_0603_1608Metric_Pad0.98x0.95mm_HandSolder
R12, R13, R14, R15, R16, R17, R22, R23: 1k; R_0603_1608Metric_Pad0.98x0.95mm_HandSolder
R18, R19: 120; R_0603_1608Metric_Pad0.98x0.95mm_HandSolder
R20: 100k; R_0603_1608Metric_Pad0.98x0.95mm_HandSolder
SP1: SMT-0440; STM0440-T-R
SW1: RESET; TVAF06A020BR; Manufacturer_Part_Number SKRPACE010; Mouser Part Number 688-SKRPACE010
SW2: USER; TVAF06A020BR; Manufacturer_Part_Number SKRPACE010; Mouser Part Number 688-SKRPACE010
U3: STM32F405RGTx; LQFP-64_10x10mm_P0.5mm
U4: MCP2562-E-SN; SOIC-8_3.9x4.9mm_P1.27mm
Y1: XRCGB16M000FXN02R0

Connections:
+3.3V: C8.1, C9.1, C10.1, C11.1, C12.1, C13.1, C17.1, J9.4 (VDD), J10.1, J11.1 (VTref), J12.4, R7.1, R8.1, R9.1, R10.1, R11.1, R21.1, R24.1, R25.1, R26.1, SP1.1, U3.1 (VBAT), U3.13 (VDDA), U3.19 (VDD), U3.32 (VDD), U3.48 (VDD), U3.64 (VDD); also elsewhere on the board
+5V: U4.3 (VDD), U4.5 (Vio); also elsewhere on the board
/can/CAN_H: R18.1, U4.7 (CANH); also elsewhere on the board
/can/CAN_L: R18.2, U4.6 (CANL); also elsewhere on the board
/imu/SPI_CLK: U3.34 (PB13); also elsewhere on the board
/imu/SPI_MISO: U3.10 (PC2); also elsewhere on the board
/imu/SPI_MOSI: U3.11 (PC3); also elsewhere on the board
/power/ADC_BATTERY: U3.27 (PB1); also elsewhere on the board
/stm32f405rg/CAN_RX: U3.44 (PA11), U4.4 (RXD)
/stm32f405rg/CAN_TX: U3.45 (PA12), U4.1 (TXD)
/stm32f405rg/LCD_DC: J10.6, U3.16 (PA2)
/stm32f405rg/LCD_RST: J10.7
/stm32f405rg/LED1: R12.1, U3.25 (PC5)
/stm32f405rg/LED2: R13.1, U3.26 (PB0)
/stm32f405rg/LED3: R15.1, U3.28 (PB2)
/stm32f405rg/LED4: R17.1, U3.30 (PB11)
/stm32f405rg/LED_CAN_RX: R23.1, U3.33 (PB12)
/stm32f405rg/LED_CAN_TX: R22.1, U3.36 (PB15)
/stm32f405rg/NRST: C14.1, J11.10 (~RESET), R14.1, R24.2, U3.7 (NRST)
/stm32f405rg/OSC_IN: R16.1, U3.5 (PH0)
/stm32f405rg/OSC_OUT: C16.1, U3.6 (PH1), Y1.3
/stm32f405rg/SDIO_CK: J9.5 (CLK), U3.53 (PC12)
/stm32f405rg/SDIO_CMD: J9.3 (CMD), R9.2, U3.54 (PD2)
/stm32f405rg/SDIO_D0: J9.7 (DAT0), R8.2, U3.39 (PC8)
/stm32f405rg/SDIO_D1: J9.8 (DAT1), R7.2, U3.40 (PC9)
/stm32f405rg/SDIO_D2: J9.1 (DAT2), R11.2, U3.51 (PC10)
/stm32f405rg/SDIO_D3: J9.2 (DAT3/CD), R10.2, U3.52 (PC11)
/stm32f405rg/SDIO_SW: J9.9 (DET_B), U3.50 (PA15)
/stm32f405rg/SPI1_CS: J10.5, U3.17 (PA3)
/stm32f405rg/SPI1_MOSI: J10.3, U3.23 (PA7)
/stm32f405rg/SPI1_SCK: J10.4, U3.21 (PA5)
/stm32f405rg/SPI2_CS1: U3.55 (PB3); also elsewhere on the board
/stm32f405rg/SPI2_CS2: U3.56 (PB4); also elsewhere on the board
/stm32f405rg/SPI2_CS3: U3.57 (PB5); also elsewhere on the board
/stm32f405rg/SPI2_CS4: U3.58 (PB6); also elsewhere on the board
/stm32f405rg/SPI2_CS5: U3.59 (PB7); also elsewhere on the board
/stm32f405rg/SPI2_CS6: U3.2 (PC13); also elsewhere on the board
/stm32f405rg/SW1: SW2.2, U3.14 (PA0)
/stm32f405rg/SWCLK: J11.4 (SWDCLK/TCK), R25.2, U3.49 (PA14)
/stm32f405rg/SWDIO: J11.2 (SWDIO/TMS), R26.2, U3.46 (PA13)
/stm32f405rg/TIM3_LCD_BL: J10.8, U3.22 (PA6)
/stm32f405rg/TIM12_SP: R19.1, U3.35 (PB14)
/stm32f405rg/USART1_RX: J12.1, U3.43 (PA10)
/stm32f405rg/USART1_TX: J12.2, U3.42 (PA9)
GND: C6.2, C7.2, C8.2, C9.2, C10.2, C11.2, C12.2, C13.2, C14.2, C15.2, C16.2, C17.2, D3.1 (K), D4.1 (K), D5.1 (K), D6.1 (K), D7.1 (K), D8.1 (K), J9.6 (VSS), J9.10 (DET_A), J9.11 (SHIELD), J10.2, J11.3 (GND), J11.5 (GND), J11.9 (GNDDetect), J12.3, Q1.2 (S), R6.2, R20.2, SW1.3, SW1.4, SW2.3, U3.12 (VSSA), U3.18 (VSS), U3.63 (VSS), U4.2 (VSS), U4.8 (STBY), Y1.2; also elsewhere on the board
unnamed: C15.1, R16.2, Y1.1
unnamed: D3.2 (A), R12.2
unnamed: D4.2 (A), R13.2
unnamed: D5.2 (A), R15.2
unnamed: D6.2 (A), R17.2
unnamed: D7.2 (A), R22.2
unnamed: D8.2 (A), R23.2
unnamed: Q1.3 (D), SP1.2
unnamed: Q1.1 (G), R19.2, R20.1
unnamed: R14.2, SW1.1
unnamed: R21.2, SW2.1
unnamed: R6.1, U3.60 (BOOT0)
unnamed: C6.1, U3.31 (VCAP_1)
unnamed: C7.1, U3.47 (VCAP_2)

Notes on the sheet:
CAN
MCU
Micro SD
Debug
IMU
HSE CLK
LCD
