Teruru-52/Cubli/pcb/main/main.kicad_pcb

## KiCad design pcb/main/main.kicad_pcb (continued)

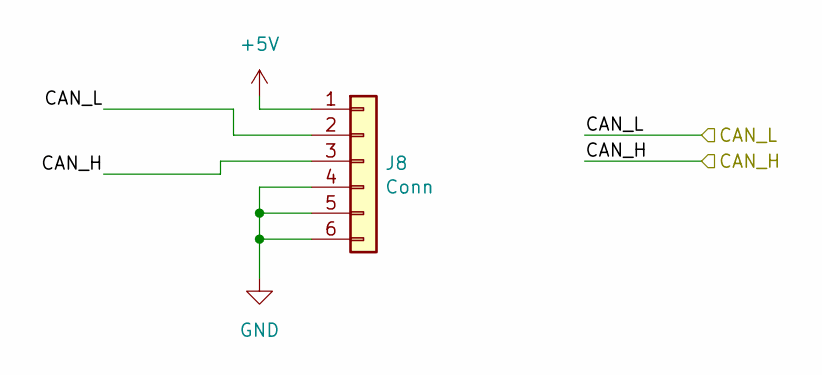
[picture p18: schematic can.kicad_sch]

Parts:
J8: Conn; 21322604YY

Connections:
+5V: J8.1; also elsewhere on the board
/can/CAN_H: J8.3; also elsewhere on the board
/can/CAN_L: J8.2; also elsewhere on the board
GND: J8.4, J8.5, J8.6; also elsewhere on the board

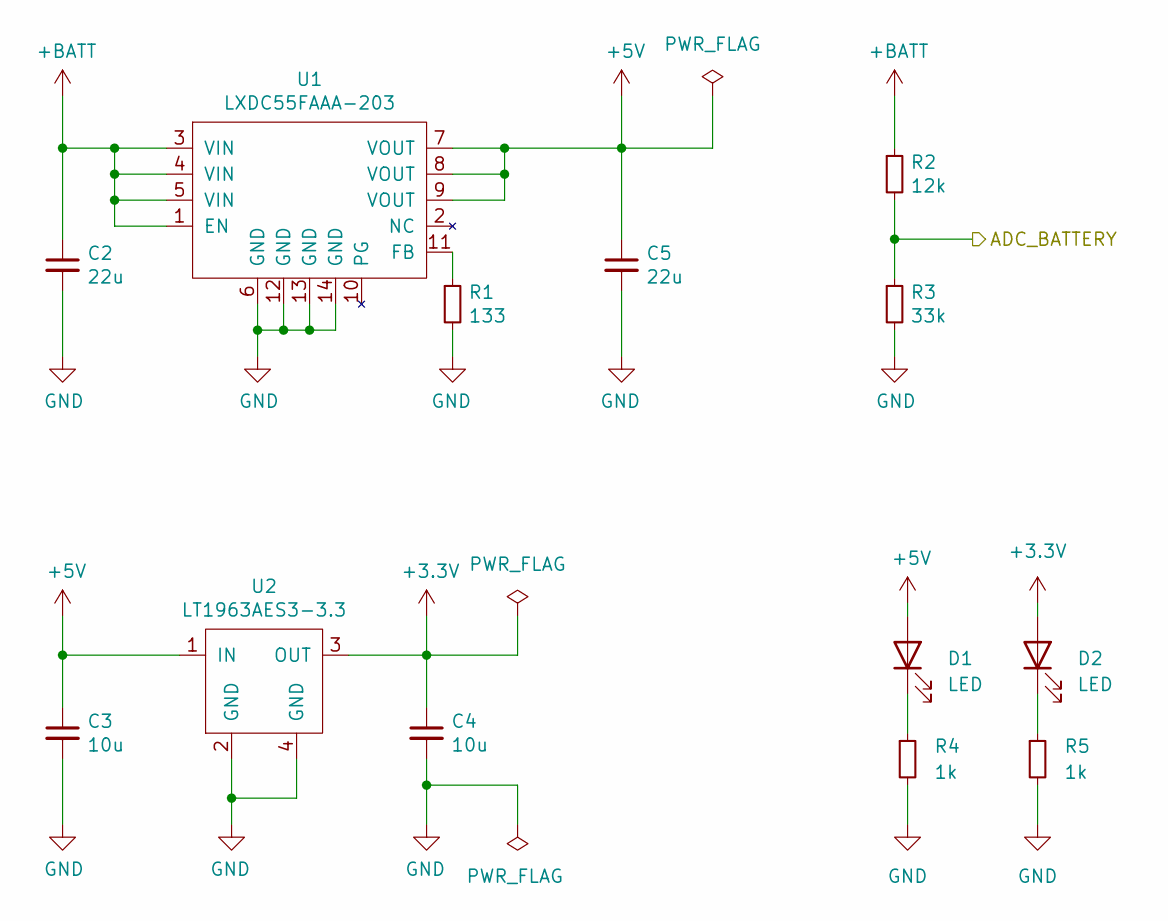
[picture p19: schematic power.kicad_sch]

Parts:
C2, C5: 22u; C_0805_2012Metric_Pad1.18x1.45mm_HandSolder
C3, C4: 10u; C_0805_2012Metric_Pad1.18x1.45mm_HandSolder
D1, D2: LED; LED_0603_1608Metric
R1: 133; R_0805_2012Metric
R2: 12k; R_0603_1608Metric
R3: 33k; R_0603_1608Metric
R4, R5: 1k; R_0603_1608Metric_Pad0.98x0.95mm_HandSolder
U1: LXDC55FAAA-203
U2: LT1963AES3-3.3; SOT-223

Connections:
+3.3V: C4.1, D2.2 (A), U2.3 (OUT); also elsewhere on the board
+5V: C3.1, C5.1, D1.2 (A), U1.7 (VOUT), U1.8 (VOUT), U1.9 (VOUT), U2.1 (IN); also elsewhere on the board
+BATT: C2.1, R2.1, U1.1 (EN), U1.3 (VIN), U1.4 (VIN), U1.5 (VIN); also elsewhere on the board
/power/ADC_BATTERY: R2.2, R3.1; also elsewhere on the board
GND: C2.2, C3.2, C4.2, C5.2, R1.2, R3.2, R4.2, R5.2, U1.6 (GND), U1.12 (GND), U1.13 (GND), U1.14 (GND), U2.2 (GND), U2.4 (GND); also elsewhere on the board
unnamed: D1.1 (K), R4.1
unnamed: D2.1 (K), R5.1
unnamed: R1.1, U1.11 (FB)

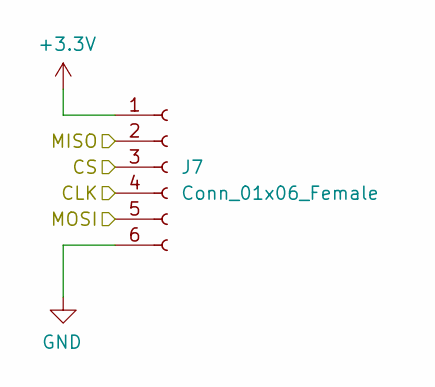
[picture p20: schematic imu_connector.kicad_sch]

Parts:
J7: Conn_01x06_Female; JST_ZE_SM06B-ZESS-TB_1x06-1MP_P1.50mm_Horizontal

Connections:
+3.3V: J7.1; also elsewhere on the board
/imu/SPI_CLK: J7.4; also elsewhere on the board
/imu/SPI_MISO: J7.2; also elsewhere on the board
/imu/SPI_MOSI: J7.5; also elsewhere on the board
/stm32f405rg/SPI2_CS6: J7.3; also elsewhere on the board
GND: J7.6; also elsewhere on the board

Parts of its further copies:
J2, J3, J4, J5, J6: Conn_01x06_Female; JST_ZE_SM06B-ZESS-TB_1x06-1MP_P1.50mm_Horizontal

Connections of its further copies:
+3.3V: J2.1, J3.1, J4.1, J5.1, J6.1; also elsewhere on the board
/imu/SPI_CLK: J2.4, J3.4, J4.4, J5.4, J6.4; also elsewhere on the board
/imu/SPI_MISO: J2.2, J3.2, J4.2, J5.2, J6.2; also elsewhere on the board
/imu/SPI_MOSI: J2.5, J3.5, J4.5, J5.5, J6.5; also elsewhere on the board
/stm32f405rg/SPI2_CS1: J2.3; also elsewhere on the board
/stm32f405rg/SPI2_CS2: J3.3; also elsewhere on the board
/stm32f405rg/SPI2_CS3: J4.3; also elsewhere on the board
/stm32f405rg/SPI2_CS4: J5.3; also elsewhere on the board
/stm32f405rg/SPI2_CS5: J6.3; also elsewhere on the board
GND: J2.6, J3.6, J4.6, J5.6, J6.6; also elsewhere on the board

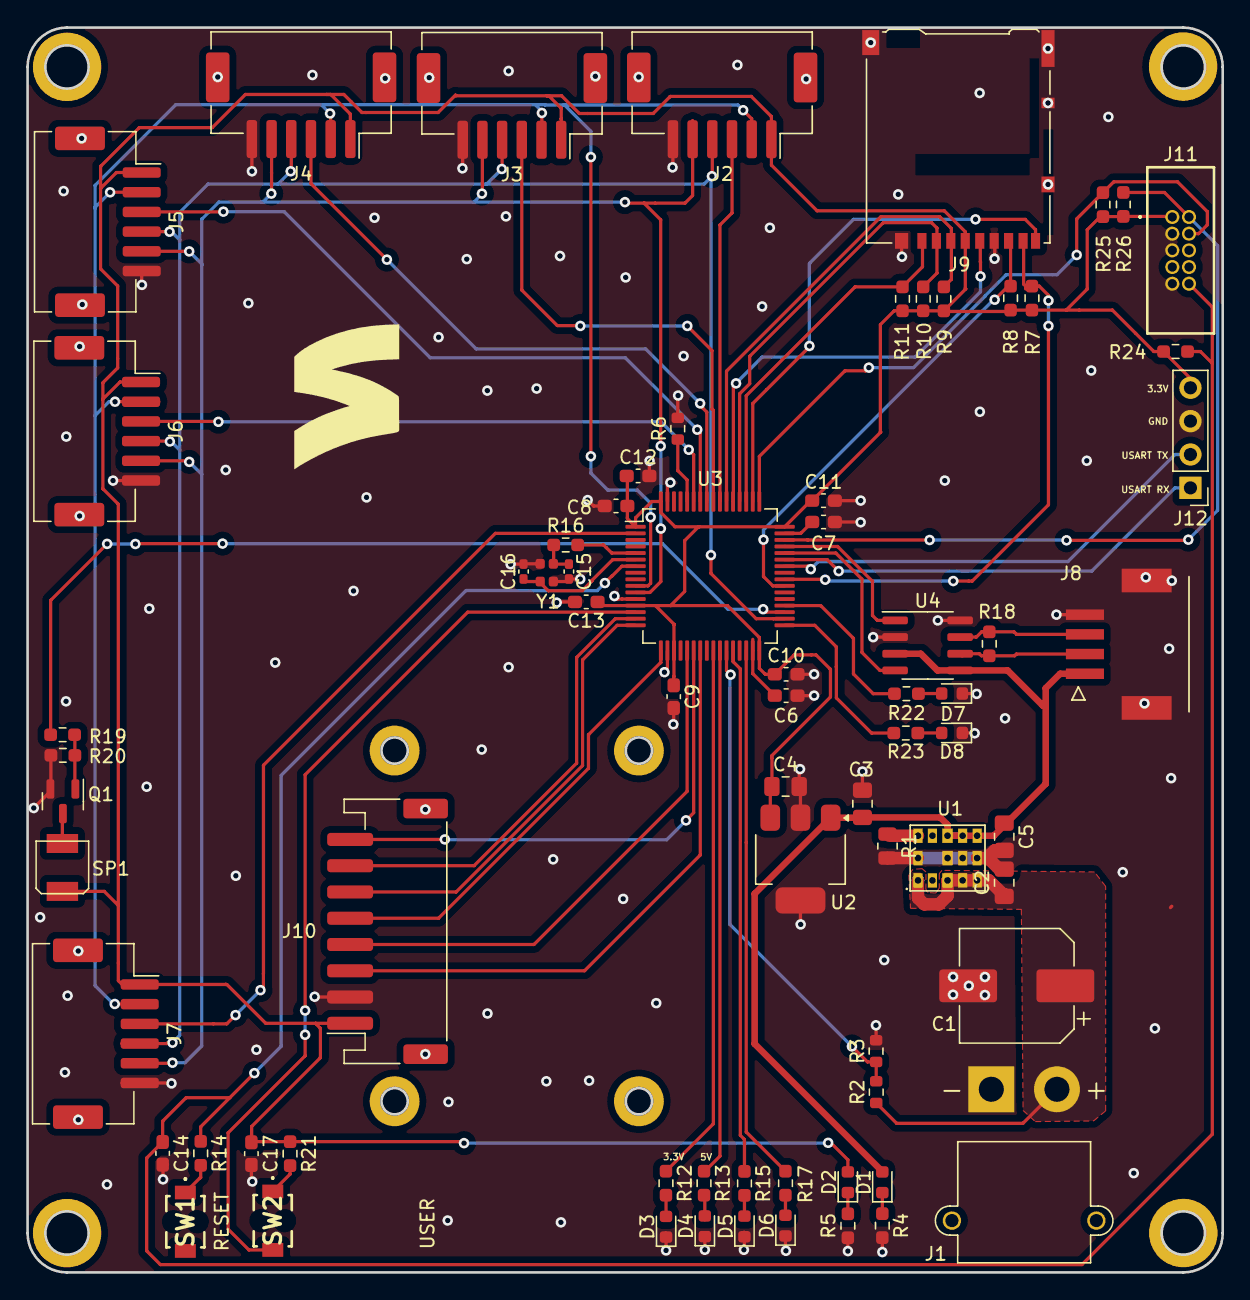
[picture p21: board main.kicad_pcb from above]

Board: 2 copper layers, 91.0 x 94.8 mm, 80 parts (0 on the bottom side), 62 nets.
