Teruru-52/Cubli/pcb/motor_driver/v1.1/motor_driver.kicad_pcb

## KiCad design pcb/motor_driver/v1.1/motor_driver.kicad_pcb (2024-05-18, an earlier design)

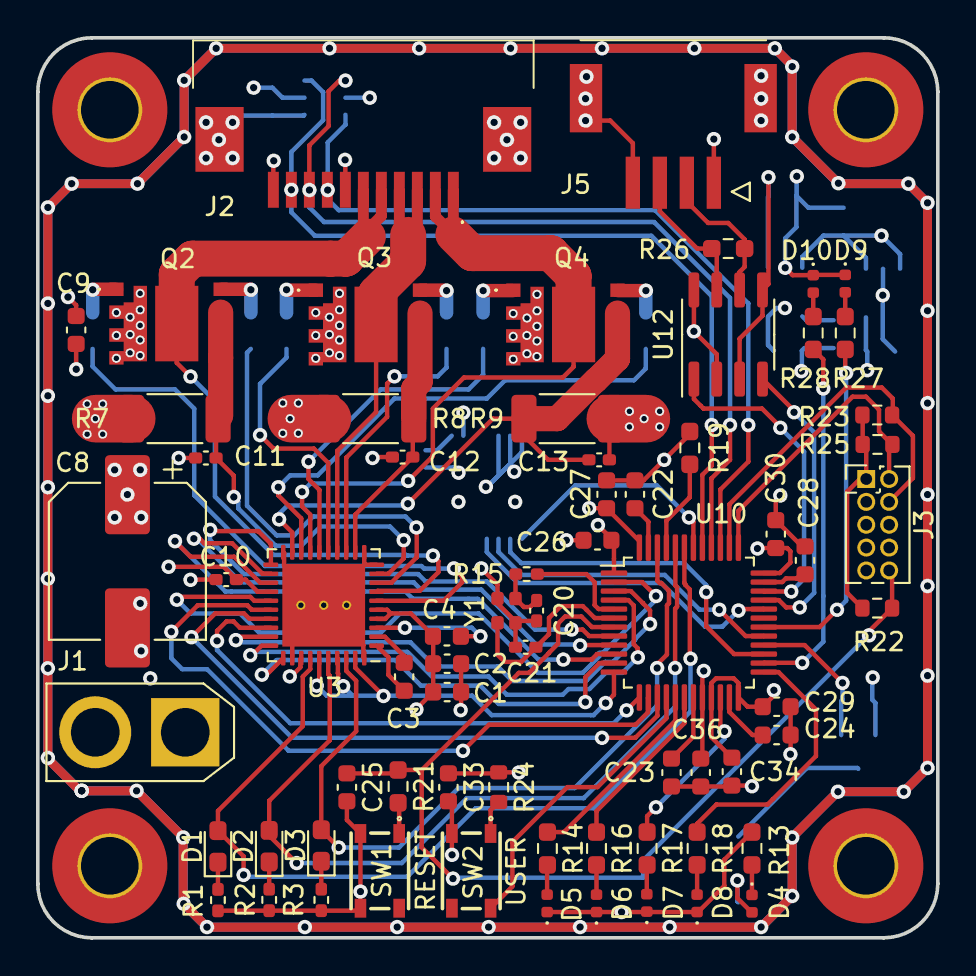
[picture p22: board pcb/motor_driver/v1.1/motor_driver.kicad_pcb from above]

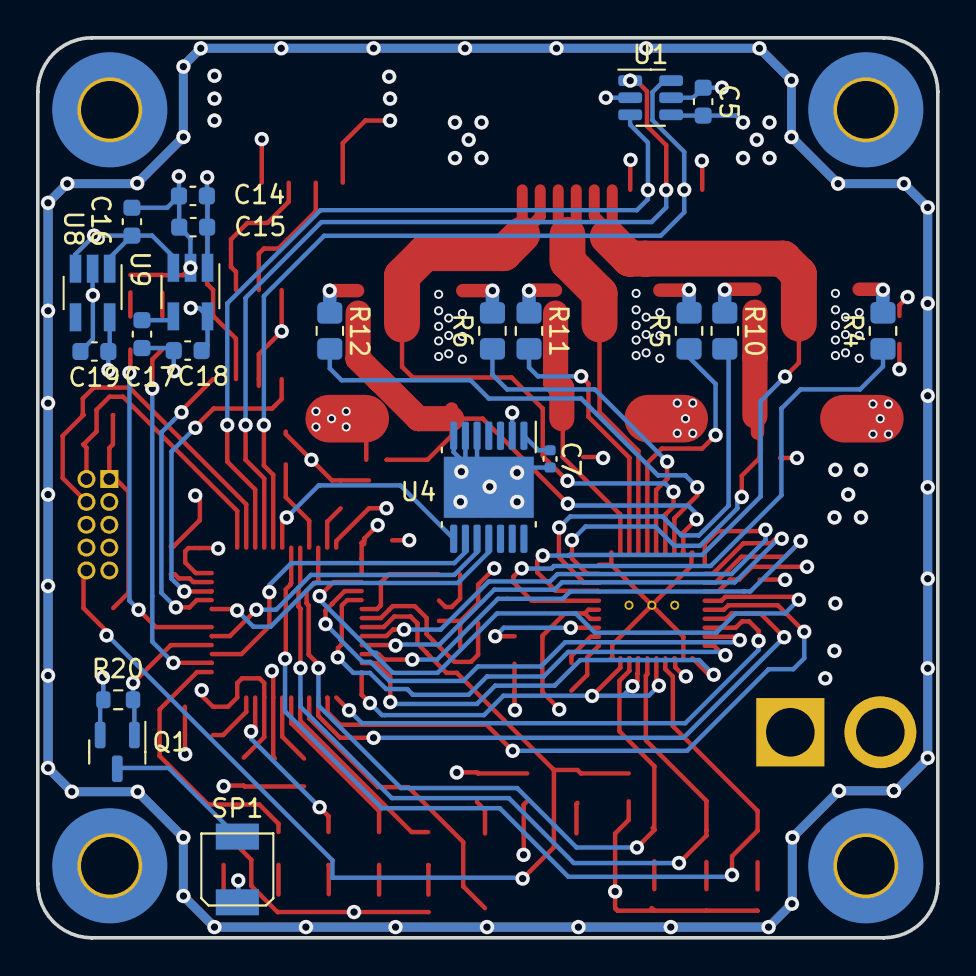
[picture p23: board pcb/motor_driver/v1.1/motor_driver.kicad_pcb from below]

Board: 4 copper layers, 50.0 x 50.0 mm, 93 parts (21 on the bottom side), 85 nets.

Parts:
C1, C26: 4.7u; C_0603_1608Metric
C2, C4, C15, C16, C18, C19: 1u; C_0603_1608Metric
C3: 0.047u; C_0603_1608Metric
C5, C25, C27, C29, C30, C33, C34, C36: 0.1u; C_0603_1608Metric
C7: 0.1u; C_0402_1005Metric
C8: 150u; CP_Elec_8x10.5
C9: 10u; C_0603_1608Metric
C10: 0.1u; C_0402_1005Metric_Pad0.74x0.62mm_HandSolder
C11, C12, C13: 1n; C_0402_1005Metric_Pad0.74x0.62mm_HandSolder
C14, C17: 0.01u; C_0603_1608Metric
C20, C21: 10p; C_0402_1005Metric_Pad0.74x0.62mm_HandSolder
C22, C23, C24, C28: 2.2u; C_0603_1608Metric
D1, D2, D3: LED; LED_0603_1608Metric_Pad1.05x0.95mm_HandSolder
D4: LED; LED_0402_1005Metric
D5: LED1; LED_0402_1005Metric
D6: LED2; LED_0402_1005Metric
D7: LED3; LED_0402_1005Metric
D8: LED4; LED_0402_1005Metric
D9: LED5; LED_0402_1005Metric
D10: LED6; LED_0402_1005Metric
H1, H2, H3, H4: MountingHole; MountingHole_3.2mm_M3_Pad_TopBottom
J1: XT60PW-M; AMASS_XT30U-F_1x02_P5.0mm_Vertical
J2: 1-84953-1
J3: Conn_ARM_JTAG_SWD_10; PinHeader_2x05_P1.27mm_Vertical
J5: Conn; 21322604YY
Q1: BSS138; SOT-23
Q2, Q3, Q4: HP8K22TB; HP8K24TB
R1, R2, R3, R15: 1k; R_0402_1005Metric_Pad0.72x0.64mm_HandSolder
R4, R5, R6, R10, R11, R12: 0; R_0805_2012Metric_Pad1.20x1.40mm_HandSolder
R7, R8, R9: 5m; R_2010_5025Metric_Pad1.40x2.65mm_HandSolder
R13, R14, R16, R17, R18, R21, R27, R28: 1k; R_0603_1608Metric_Pad0.98x0.95mm_HandSolder
R19: 10k; R_0603_1608Metric_Pad0.98x0.95mm_HandSolder
R20: 100k; R_0603_1608Metric
R22, R23, R24, R25: 10k; R_0603_1608Metric
R26: 120; R_0603_1608Metric_Pad0.98x0.95mm_HandSolder
SP1: SMT-0440; STM0440-T-R
SW1: RESET; SKRPACE010
SW2: USER; SKRPACE010
U1: USBLC6-4SC6; SOT-23-6
U3: DRV8323S; QFN-40-1EP_6x6mm_P0.5mm_EP4.6x4.6mm
U4: a1333; HTSSOP-14-1EP_4.4x5mm_P0.65mm_EP3.4x5mm_Mask3x3.1mm
U8: ADP151AUJZ-3.3-R7; SOT-23-5_HandSoldering
U9: NJM12877F33-TE1; SOT-23-5_HandSoldering
U10: STM32G431CB; LQFP-48_7x7mm_P0.5mm
U12: MCP2562-E-SN; SOIC-8_3.9x4.9mm_P1.27mm
Y1: XRCGB16M000FXN02R0

Connections:
+3.3V: C18.1, C26.1, C27.1, C29.1, C30.1, C33.1, C34.1, D4.2 (A), J3.1 (VTref), R22.1, R23.1, R24.1, R25.1, SP1.1, U3.33 (DVDD), U9.5 (VOUT), U10.1 (VBAT), U10.21 (VDDA), U10.24 (VDD), U10.36 (VDD), U10.48 (VDD)
+3.3VA: C10.1, C19.1, C36.1, U3.24 (VREF), U8.5 (VOUT), U10.20 (VREF+)
+5V: C5.1, C14.1, C15.1, C16.1, J2.11, J5.1, U1.5 (VBUS), U4.2 (VCC), U8.1 (VIN), U8.3 (EN), U9.1 (VIN), U9.3 (CONTROL), U12.3 (VDD), U12.5 (Vio)
+BATT: C1.1, C2.1, C4.1, C8.1, C9.1, J1.2, Q2.2 (TR1_DRAIN1), Q2.3 (TR1_DRAIN2), Q2.4 (TR1_DRAIN3), Q2.10 (TR1_DRAIN4), Q2.11 (TR1_DRAIN5), Q3.2 (TR1_DRAIN1), Q3.3 (TR1_DRAIN2), Q3.4 (TR1_DRAIN3), Q3.10 (TR1_DRAIN4), Q3.11 (TR1_DRAIN5), Q4.2 (TR1_DRAIN1), Q4.3 (TR1_DRAIN2), Q4.4 (TR1_DRAIN3), Q4.10 (TR1_DRAIN4), Q4.11 (TR1_DRAIN5), U3.4 (VM), U3.5 (VDRAIN)
/drv8323/GHA: R4.1, U3.6 (GHA)
/drv8323/GHB: R5.1, U3.15 (GHB)
/drv8323/GHC: R6.1, U3.16 (GHC)
/drv8323/GLA: R10.2, U3.8 (GLA)
/drv8323/GLB: R11.2, U3.13 (GLB)
/drv8323/GLC: R12.2, U3.18 (GLC)
/drv8323/HALL_U: J2.9, U1.1 (I/O1), U10.40 (PB3)
/drv8323/HALL_V: J2.8, U1.3 (I/O2), U10.39 (PA15)
/drv8323/HALL_W: J2.10, U1.6 (I/O4), U10.41 (PB4)
/drv8323/INHA: D1.2 (A), U3.34 (INHA), U10.43 (PB6)
/drv8323/INHB: D2.2 (A), U3.36 (INHB), U10.44 (PB7)
/drv8323/INHC: D3.2 (A), U3.38 (INHC), U10.46 (PB9)
/drv8323/SHA: J2.5, J2.6, Q2.9 (TR1_SOURCE/TR2_DRAIN), U3.7 (SHA)
/drv8323/SHB: J2.3, J2.4, Q3.9 (TR1_SOURCE/TR2_DRAIN), U3.14 (SHB)
/drv8323/SHC: J2.1, J2.2, Q4.9 (TR1_SOURCE/TR2_DRAIN), U3.17 (SHC)
/drv8323/SLA: C11.1, Q2.5 (TR2_SOURCE1), Q2.6 (TR2_SOURCE2), Q2.7 (TR2_SOURCE3), R7.2, U3.9 (SPA)
/drv8323/SLB: C12.1, Q3.5 (TR2_SOURCE1), Q3.6 (TR2_SOURCE2), Q3.7 (TR2_SOURCE3), R8.2, U3.12 (SPB)
/drv8323/SLC: C13.1, Q4.5 (TR2_SOURCE1), Q4.6 (TR2_SOURCE2), Q4.7 (TR2_SOURCE3), R9.2, U3.19 (SPC)
/drv8323/SPI1_CLK: U3.28 (SCLK), U10.13 (PA5)
/drv8323/SPI1_MISO: U3.26 (SDO), U10.14 (PA6)
/drv8323/SPI1_MOSI: U3.27 (SDI), U10.15 (PA7)
/drv8323/SPI2_CLK: U4.9 (SCLK), U10.27 (PB13)
/drv8323/SPI2_MISO: U4.11 (MISO), U10.32 (PA10)
/drv8323/SPI2_MOSI: U4.10 (MOSI_SA1), U10.29 (PB15)
/drv8323/SS_ENC: U4.8 (CS/SA0), U10.42 (PB5)
/stm32g431cb/ADC1_1: U3.21 (SOC), U10.8 (PA0)
/stm32g431cb/ADC1_2: U3.22 (SOB), U10.9 (PA1)
/stm32g431cb/ADC1_3: U3.23 (SOA), U10.10 (PA2)
/stm32g431cb/CAN_H: J5.3, R26.1, U12.7 (CANH)
/stm32g431cb/CAN_L: J5.2, R26.2, U12.6 (CANL)
/stm32g431cb/CAN_RX: U10.33 (PA11), U12.4 (RXD)
/stm32g431cb/CAN_TX: U10.34 (PA12), U12.1 (TXD)
/stm32g431cb/DRV_CAL: U3.31 (CAL), U10.11 (PA3)
/stm32g431cb/DRV_ENABLE: U3.30 (ENABLE), U10.4 (PC15)
/stm32g431cb/FAULTB: U3.25 (nFAULT), U10.2 (PC13)
/stm32g431cb/INLX: U3.35 (INLA), U3.37 (INLB), U3.39 (INLC), U10.12 (PA4)
/stm32g431cb/LED1: R14.1, U10.17 (PB1)
/stm32g431cb/LED2: R16.1, U10.18 (PB2)
/stm32g431cb/LED3: R17.1, U10.22 (PB10)
/stm32g431cb/LED4: R18.1, U10.25 (PB11)
/stm32g431cb/LED_CAN_RX: R28.1, U10.26 (PB12)
/stm32g431cb/LED_CAN_TX: R27.1, U10.30 (PA8)
/stm32g431cb/NRST: C25.1, J3.10 (~RESET), R21.1, R22.2, U10.7 (PG10-NRST)
/stm32g431cb/OSC_IN: R15.1, U10.5 (PF0-OSC_IN)
/stm32g431cb/OSC_OUT: C21.1, U10.6 (PF0-OSC_OUT), Y1.3
/stm32g431cb/SS_DRV: U3.29 (nSCS), U10.3 (PC14)
/stm32g431cb/SW1: SW2.2, U10.16 (PB0)
/stm32g431cb/SWCLK: J3.4 (SWDCLK/TCK), R23.2, U10.38 (PA14)
/stm32g431cb/SWDIO: J3.2 (SWDIO/TMS), R25.2, U10.37 (PA13)
/stm32g431cb/TIM15_SP: Q1.1 (G), R20.1, U10.28 (PB14)
GND: C1.2, C2.2, C5.2, C7.2, C8.2, C9.2, C10.2, C11.2, C12.2, C13.2, C14.2, C15.2, C16.2, C17.2, C18.2, C19.2, C20.2, C21.2, C22.2, C23.2, C24.2, C25.2, C26.2, C27.2, C28.2, C29.2, C30.2, C33.2, C34.2, C36.2, D5.1 (K), D6.1 (K), D7.1 (K), D8.1 (K), D9.1 (K), D10.1 (K), J1.1, J2.7, J2.MP1, J2.MP2, J3.3 (GND), J3.5 (GND), J3.9 (GNDDetect), J5.4, J5.5, J5.6, Q1.2 (S), R1.2, R2.2, R3.2, R7.1, R8.1, R9.1, R13.2, R19.2, R20.2, SW1.3, SW1.4, SW2.3, U1.2 (GND), U1.4 (I/O3), U3.10 (SNA), U3.11 (SNB), U3.20 (SNC), U3.32 (AGND), U3.40 (PGND), U3.41 (GND), U4.5 (GND), U4.6 (GND), U4.7 (GND), U4.15 (GND), U8.2 (GND), U9.2 (GND), U12.2 (VSS), U12.8 (STBY), Y1.2
unnamed: C3.1, U3.1 (CPL)
unnamed: C3.2, U3.2 (CPH)
unnamed: C4.2, U3.3 (VCP)
unnamed: C7.1, U4.1 (BYP)
unnamed: C17.1, U9.4 (Cs)
unnamed: C20.1, R15.2, Y1.1
unnamed: C22.1, U10.47 (VSS)
unnamed: C23.1, U10.19 (VSSA)
unnamed: C24.1, U10.23 (VSS)
unnamed: C28.1, U10.35 (VSS)
unnamed: D1.1 (K), R1.1
unnamed: D2.1 (K), R2.1
unnamed: D3.1 (K), R3.1
unnamed: D4.1 (K), R13.1
unnamed: D5.2 (A), R14.2
unnamed: D6.2 (A), R16.2
unnamed: D7.2 (A), R17.2
unnamed: D8.2 (A), R18.2
unnamed: D9.2 (A), R27.2
unnamed: D10.2 (A), R28.2
unnamed: Q1.3 (D), SP1.2
unnamed: Q2.1 (TR1_GATE), R4.2
unnamed: Q2.8 (TR2_GATE), R10.1
unnamed: Q3.1 (TR1_GATE), R5.2
unnamed: Q3.8 (TR2_GATE), R11.1
unnamed: Q4.1 (TR1_GATE), R6.2
unnamed: Q4.8 (TR2_GATE), R12.1
unnamed: R19.1, U10.45 (PB8-BOOT0)
unnamed: R21.2, SW1.1
unnamed: R24.2, SW2.1
