Teruru-52/Cubli/pcb/imu/imu.kicad_pcb

## KiCad design pcb/imu/imu.kicad_pcb (2023-08-14)

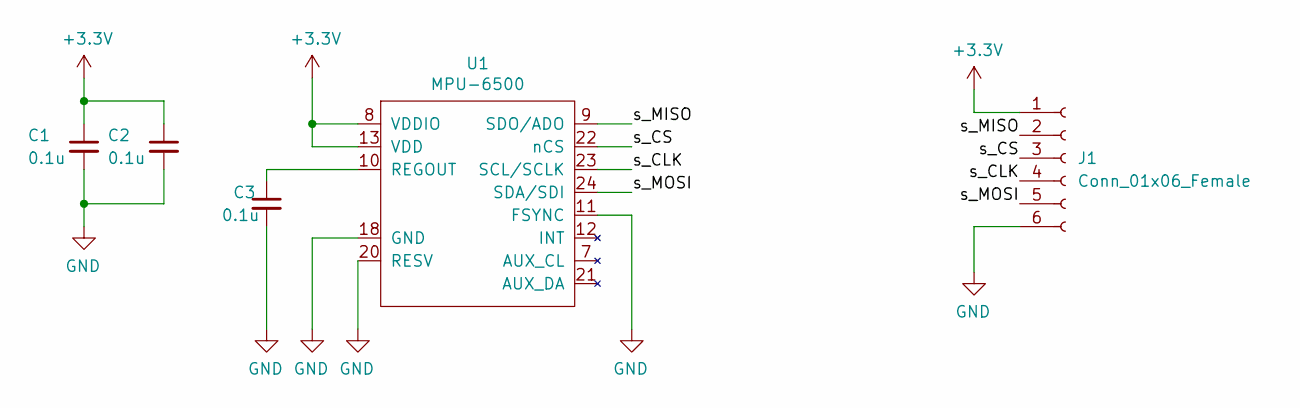
[picture p24: schematic imu.kicad_sch]

Parts:
C1, C2, C3: 0.1u; C_0603_1608Metric_Pad1.08x0.95mm_HandSolder
J1: Conn_01x06_Female; JST_ZE_BM06B-ZESS-TBT_1x06-1MP_P1.50mm_Vertical
U1: MPU-6500; QFN-24-1EP_3x3mm_P0.4mm_EP1.75x1.6mm

Connections:
+3.3V: C1.1, C2.1, J1.1, U1.8 (VDDIO), U1.13 (VDD)
/s_CLK: J1.4, U1.23 (SCL/SCLK)
/s_CS: J1.3, U1.22 (nCS)
/s_MISO: J1.2, U1.9 (SDO/ADO)
/s_MOSI: J1.5, U1.24 (SDA/SDI)
GND: C1.2, C2.2, C3.2, J1.6, U1.11 (FSYNC), U1.18 (GND), U1.20 (RESV)
unnamed: C3.1, U1.10 (REGOUT)

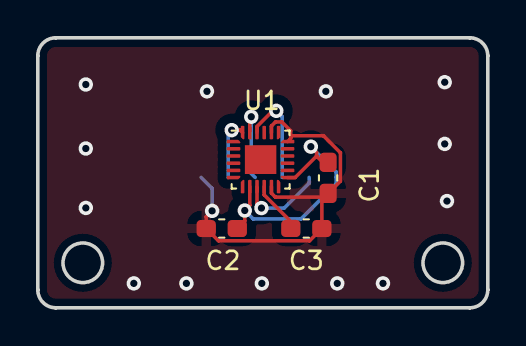
[picture p25: board imu.kicad_pcb from above]

Board: 2 copper layers, 25.0 x 15.0 mm, 5 parts (1 on the bottom side), 7 nets.
