Teruru-52/Cubli/firmware/main_board/Core/Src/main.c

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
/* Includes ------------------------------------------------------------------*/
#include "main.h"
#include "cmsis_os.h"
#include "can.h"
#include "fatfs.h"
#include "sdio.h"
#include "spi.h"
#include "tim.h"
#include "usart.h"
#include "gpio.h"

/* USER CODE BEGIN Includes */
#include "main_exec.h"
#include "LCD_Test.h"
/* USER CODE END Includes */


void SystemClock_Config(void);
void MX_FREERTOS_Init(void);
/* USER CODE BEGIN 0 */
int cnt1kHz = 0;

void SDIO_Test()
{
  FATFS SDFatFs;                  /* File system object for SD disk logical drive */
  FIL MyFile;                     /* File object */
  char SDPath[4];                 /* SD disk logical drive path */
  static uint8_t buffer[_MAX_SS]; /* a work buffer for the f_mkfs() */

  FRESULT res;                                              /* FatFs function common result code */
  uint32_t byteswritten, bytesread;                         /* File write/read counts */
  uint8_t wtext[] = "Hi, this is STM32 working with FatFs"; /* File write buffer */
  uint8_t rtext[100];                                       /* File read buffer */

  /*##-1- Link the SD disk I/O driver ########################################*/
  if (FATFS_LinkDriver(&SD_Driver, SDPath) == 0)
  {
    /*##-2- Register the file system object to the FatFs module ##############*/
    if (f_mount(&SDFatFs, (TCHAR const *)SDPath, 0) != FR_OK)
    {
      /* FatFs Initialization Error */
      Error_Handler();
    }
    else
    {
      /*##-3- Create a FAT file system (format) on the logical drive #########*/

      FRESULT fr;
      fr = f_mkfs((TCHAR const *)SDPath, FM_ANY, 0, buffer, sizeof(buffer));
      if (fr != FR_OK)
      {
        Error_Handler();
      }
      else
      {
        /*##-4- Create and Open a new text file object with write access #####*/
        if (f_open(&MyFile, "STM32.TXT", FA_CREATE_ALWAYS | FA_WRITE) != FR_OK)
        {
          /* 'STM32.TXT' file Open for write Error */
          Error_Handler();
        }
        else
        {
          /*##-5- Write data to the text file ################################*/
          res = f_write(&MyFile, wtext, sizeof(wtext), (void *)&byteswritten);

          if ((byteswritten == 0) || (res != FR_OK))
          {
            /* 'STM32.TXT' file Write or EOF Error */
            Error_Handler();
          }
          else
          {
            /*##-6- Close the open text file #################################*/
            f_close(&MyFile);

            /*##-7- Open the text file object with read access ###############*/
            if (f_open(&MyFile, "STM32.TXT", FA_READ) != FR_OK)
            {
              /* 'STM32.TXT' file Open for read Error */
              Error_Handler();
            }
            else
            {
              /*##-8- Read data from the text file ###########################*/
              res = f_read(&MyFile, rtext, sizeof(rtext), (UINT *)&bytesread);

              if ((bytesread == 0) || (res != FR_OK)) /* EOF or Error */
              {
                /* 'STM32.TXT' file Read or EOF Error */
                Error_Handler();
              }
              else
              {
                /*##-9- Close the open text file #############################*/
                f_close(&MyFile);

                /*##-10- Compare read data with the expected data ############*/
                if ((bytesread != byteswritten))
                {
                  /* Read data is different from the expected data */
                  Error_Handler();
                }
                else
                {
                  /* Success of the demo: no error occurrence */
                }
              }
            }
          }
        }
      }
    }
  }

  /*##-11- Unlink the SD disk I/O driver ####################################*/
  FATFS_UnLinkDriver(SDPath);
}
/* USER CODE END 0 */

/**
 * @brief  The application entry point.
 * @retval int
 */
int main(void)
{

  /* MCU Configuration--------------------------------------------------------*/

  /* Reset of all peripherals, Initializes the Flash interface and the Systick. */
  HAL_Init();

  /* Configure the system clock */
  SystemClock_Config();

  /* Initialize all configured peripherals */
  MX_GPIO_Init();
  MX_CAN1_Init();
  MX_TIM1_Init();
  MX_SPI1_Init();
  MX_SDIO_SD_Init();
  MX_SPI2_Init();
  MX_TIM3_Init();
  MX_TIM12_Init();
  MX_FATFS_Init();
  MX_USART1_UART_Init();
  /* USER CODE BEGIN 2 */
  SEGGER_RTT_Init();
  HAL_TIM_PWM_Start(&htim12, TIM_CHANNEL_1);
  // HAL_UART_Receive_DMA(&huart1, RdBuff, RCV_BUFF_SIZE);
  if (HAL_CAN_ActivateNotification(&hcan1, CAN_IT_RX_FIFO0_MSG_PENDING) != HAL_OK)
  {
    Error_Handler();
  }
  Reset_CS_Pin();

  // SDIO_Test();

  __HAL_TIM_SET_COMPARE(&htim12, TIM_CHANNEL_1, 20);
  HAL_Delay(50);
  __HAL_TIM_SET_COMPARE(&htim12, TIM_CHANNEL_1, 0);

  // LCD_1in14_test();
  // LCD_1in28_test();

  Initialize();

  HAL_TIM_Base_Start_IT(&htim1);

  /* USER CODE END 2 */

  /* Call init function for freertos objects (in cmsis_os2.c) */
  MX_FREERTOS_Init();

  /* Start scheduler */
  osKernelStart();

  /* We should never get here as control is now taken by the scheduler */

  /* Infinite loop */
  /* USER CODE BEGIN WHILE */
  while (1)
  {
    /* USER CODE END WHILE */

    /* USER CODE BEGIN 3 */
  }
  /* USER CODE END 3 */
}

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
/**
 * @brief  Period elapsed callback in non blocking mode
 * @note   This function is called  when TIM2 interrupt took place, inside
 * HAL_TIM_IRQHandler(). It makes a direct call to HAL_IncTick() to increment
 * a global variable "uwTick" used as application time base.
 * @param  htim : TIM handle
 * @retval None
 */
void HAL_TIM_PeriodElapsedCallback(TIM_HandleTypeDef *htim)
{
  if (htim->Instance == TIM2)
  {
    HAL_IncTick();
  }
  /* USER CODE BEGIN Callback 1 */
  if (htim->Instance == TIM1) // interruption 1kHz
  {
    cnt1kHz = (cnt1kHz + 1) % 1000;

    if (cnt1kHz % 10 == 0) // interruption 100Hz
    {
      UpdateIMUs();
      CAN_Send();
    }

    if (cnt1kHz % 200 == 0) // interruption 5Hz
    {
      LogPrint();
    }

    if (cnt1kHz == 0) // interruption 1Hz
      Toggle_GPIO(LED_WHITE);
  }
  /* USER CODE END Callback 1 */
}

/**
 * @brief  This function is executed in case of error occurrence.
 * @retval None
 */
void Error_Handler(void)
{
  /* USER CODE BEGIN Error_Handler_Debug */
  /* User can add his own implementation to report the HAL error return state */
  __disable_irq();
  while (1)
  {
  }
  /* USER CODE END Error_Handler_Debug */
}

#ifdef USE_FULL_ASSERT
/**
 * @brief  Reports the name of the source file and the source line number
 *         where the assert_param error has occurred.
 * @param  file: pointer to the source file name
 * @param  line: assert_param error line source number
 * @retval None
 */
void assert_failed(uint8_t *file, uint32_t line)
{
  /* USER CODE BEGIN 6 */
  /* User can add his own implementation to report the file name and line number,
     ex: printf("Wrong parameters value: file %s on line %d\r\n", file, line) */
  /* USER CODE END 6 */
}
#endif /* USE_FULL_ASSERT */
