Teruru-52/Cubli/firmware/motor_driver/motor_driver.ioc

Mcu.UserName=STM32G431CBTx
PA0.Signal=ADC1_IN1
PA1.Signal=ADC1_IN2
PA10.Signal=SPI2_MISO
PA11.Signal=FDCAN1_RX
PA12.Signal=FDCAN1_TX
PA13.Signal=SYS_JTMS-SWDIO
PA14.Signal=SYS_JTCK-SWCLK
PA15.GPIO_Label=Hall_W
PA15.Signal=GPXTI15
PA2.Signal=ADC1_IN3
PA3.GPIO_Label=CAL
PA3.Signal=GPIO_Output
PA4.GPIO_Label=ENABLE
PA4.Signal=GPIO_Output
PA5.Signal=SPI1_SCK
PA6.Signal=SPI1_MISO
PA7.Signal=SPI1_MOSI
PA8.GPIO_Label=LED_CAN_TX
PA8.Signal=GPIO_Output
PA9.GPIO_Label=LED_CAN_RX
PA9.Signal=GPIO_Output
PB0.GPIO_Label=SPI_CS_DRV
PB0.Signal=GPIO_Output
PB1.GPIO_Label=nFAULT
PB1.Signal=GPIO_Input
PB10.GPIO_Label=LED1
PB10.Signal=GPIO_Output
PB11.GPIO_Label=LED2
PB11.Signal=GPIO_Output
PB12.GPIO_Label=LED3
PB12.Signal=GPIO_Output
PB13.Signal=SPI2_SCK
PB14.GPIO_Label=LED4
PB14.Signal=GPIO_Output
PB15.Signal=SPI2_MOSI
PB2.GPIO_Label=SW
PB2.Signal=GPIO_Input
PB3.GPIO_Label=Hall_U
PB3.Signal=GPXTI3
PB4.GPIO_Label=Hall_V
PB4.Signal=GPXTI4
PB5.GPIO_Label=SPI_CS_ENC
PB5.Signal=GPIO_Output
PB6.Signal=S_TIM4_CH1
PB7.Signal=S_TIM4_CH2
PB9.Signal=S_TIM4_CH4
PC13.GPIO_Label=INLC
PC13.Signal=GPIO_Output
PC14-OSC32_IN.GPIO_Label=INLB
PC14-OSC32_IN.Signal=GPIO_Output
PC15-OSC32_OUT.GPIO_Label=INLA
PC15-OSC32_OUT.Signal=GPIO_Output
PF0-OSC_IN.Signal=RCC_OSC_IN
PF1-OSC_OUT.Signal=RCC_OSC_OUT
