Teruru-52/Cubli/firmware/motor_driver/Application/Src/main_exec.cpp

/*
 * main_exec.cpp
 *
 *  Created on: Aug 13th, 2023
 *      Author: Reiji Terunuma
 */

#define FDCAN_RECEIVE_INTERVAL_TIMEOUT_VALUE 1000

#include "main_exec.h"
#include "instance.h"
#include "driver_controller.h"
#include "fdcan.h"
#include "SEGGER_RTT.h"

bool can_received = false;
uint32_t can_receive_interval = 0;

uint32_t period_count = 0;
bool TIM_rising_edge = false;
bool Update_and_send = false;

uint8_t TxData[8];

using namespace protocol;
enum class LEDState
{
    yet_inited,
    inited,
    stop
};
LEDState led_state = LEDState::yet_inited;

void HAL_GPIO_EXTI_Callback(uint16_t GPIO_Pin)
{
    if (GPIO_Pin == Hall_U_Pin)
        hall.SetHallValueU(Read_GPIO(HALL_U));
    if (GPIO_Pin == Hall_V_Pin)
        hall.SetHallValueV(Read_GPIO(HALL_V));
    if (GPIO_Pin == Hall_W_Pin)
        hall.SetHallValueW(Read_GPIO(HALL_W));
    // hall.FlashLED();
}

void InitializeDriver()
{
    driver_controller->Initialize();
}

void TIMUpdate()
{
    // TIM_rising_edge = !TIM_rising_edge;
    // if (TIM_rising_edge)
    // {
    //     Write_GPIO(LED_RED, GPIO_PIN_SET);
    //     LEDUpdate();
    //     can_receive_interval++;
    //     if (can_receive_interval > FDCAN_RECEIVE_INTERVAL_TIMEOUT_VALUE)
    //     {
    //         led_state = LEDState::yet_inited;
    //         can_received = false;
    //         if (driver_controller != nullptr)
    //             driver_controller->Reset();
    //         driver_controller = nullptr;
    //         initialized = false;
    //     }
    //     if (driver_controller == nullptr || !initialized)
    //         return;
    //     else
    //         period_count++;

    //     // if (period_count % driver_controller->GetPeriod() == 0)
    //     // {
    //     // Update_and_send = true;
    //     // driver_controller->UpdateInTimerCallback(TIM_rising_edge);
    //     // }
    //     // else
    //     // {
    //     //     Update_and_send = false;
    //     // }
    //     Write_GPIO(LED_RED, GPIO_PIN_RESET);
    // }
    // else
    // {
    //     if (driver_controller == nullptr || !initialized)
    //         return;
    //     if (Update_and_send)
    //     {
    //         // driver_controller->UpdateInTimerCallback(TIM_rising_edge);
    //         // driver_controller->SendData();
    //     }
    // }

    encoder.Update();

    TxData[0] = 3;
    FDCAN_Send(TxData);
}

void ADCCpltCallback()
{
    // if (driver_controller->GetCalibrationFlag() == false) // if calibration is needed
    // {
    //     driver_controller->SetCurrentoffset();
    //     Write_GPIO(LED_RED, GPIO_PIN_RESET);
    // }
    if (driver_controller == nullptr) // if driver_controller is not initialized
    {
        driver_controller->SetPwm(0.0, 0.0, 0.0);
        return;
    }
    else
    {
        // Write_GPIO(LED_RED, GPIO_PIN_SET);
        //     if (!can_received)
        //         PWM_Update(&blcd_pwm, 0.0, 0.0, 0.0);
        //     else
        //     {
        if (driver_controller->GetInitilizationFlag())
        {
            driver_controller->Control();
            driver_controller->SetPwm();
        }
        //     }
    }
}

void FDCANReceiveCallback(uint8_t *pRxData)
{
    // Buffer<64> can_buf;
    // uint8_t DataSize = 0;
    // uint32_t ID = 0;
    // uint8_t RxData[64] = {0};
    // DataSize = FDCAN_Receive(&ID, RxData);
    // if (ID != CAN_ID_TX || DataSize == 0)
    // {
    //     return;
    // }
    // BLMD_Access_Lamp.FDCAN_RX = ENABLE;
    // can_receive_interval = 0;
    // can_received = true;
    // for (uint8_t i = 0; i < DataSize; i++)
    //     can_buf.push_back(RxData[i]);

    // switch (led_state)
    // {
    // case LEDState::yet_inited:
    // {
    //     MessageHeader header = static_cast<MessageHeader>(can_buf[0]);
    //     if (header == MessageHeader::init)
    //     {
    //         encoder.Reset();

    //         // ControlMode control_mode = static_cast<ControlMode>(can_buf[1]);
    //         // if (control_mode == ControlMode::voltage)
    //         //     driver_controller = &voltage_driver;
    //         // else if (control_mode == ControlMode::current)
    //         //     driver_controller = &current_driver;
    //         // else if (control_mode == ControlMode::motor_identification)
    //         //     driver_controller = &motor_identification;
    //         // else
    //         //     return;

    //         driver_controller->Initialize(can_buf);
    //         led_state = LEDState::inited;
    //     }
    //     return;
    // }
    // case LEDState::inited:
    // case LEDState::stop:
    // {
    //     MessageHeader header = static_cast<MessageHeader>(can_buf[0]);
    //     if (header == MessageHeader::tx)
    //     {
    //         driver_controller->ReceiveAndUpdateData(can_buf);
    //         led_state = LEDState::inited;
    //     }
    //     else if (header == MessageHeader::stop)
    //     {
    //         PWM_Update(&blcd_pwm, 0.0, 0.0, 0.0);
    //         led_state = LEDState::stop;
    //     }
    //     else if (header == MessageHeader::free)
    //     {
    //         PWM_Stop();
    //         led_state = LEDState::stop;
    //     }
    //     else
    //     {
    //         PWM_Update(&blcd_pwm, 0.0, 0.0, 0.0);
    //         can_buf.pop_front();
    //     }
    // }
    // }
}

void LogPrint()
{
    // encoder.LogPrint();
    // hall.LogPrint();

    // uint16_t flag_err = encoder.GetErrFlag();
    // printf("flag_err = %x\n", flag_err);

    driver_controller->LogPrint();
}

void TestHallSensor()
{
    // hall.ReadHallValue();
    hall.FlashLED();
}

void TestEncoder()
{
    encoder.Update();
}

void TestElectricAngle()
{
    driver_controller->UpdateSensorAngle();
    hall.FlashLED();
}

void LEDUpdate()
{
    switch (led_state)
    {
    case LEDState::yet_inited:
        Write_GPIO(LED_WHITE, GPIO_PIN_SET);
        Write_GPIO(LED_BLUE, GPIO_PIN_RESET);
        break;
    case LEDState::inited:
        Write_GPIO(LED_WHITE, GPIO_PIN_RESET);
        Write_GPIO(LED_BLUE, GPIO_PIN_SET);
        break;
    case LEDState::stop:
        Write_GPIO(LED_WHITE, GPIO_PIN_SET);
        Write_GPIO(LED_BLUE, GPIO_PIN_SET);
        break;
    }
}
