Teruru-52/Cubli/firmware/motor_driver/Application/Src/pid_controller.cpp

#include "pid_controller.h"

Integrator::Integrator(float control_period, float bound_windup)
    : control_period(control_period),
      bound_windup(bound_windup),
      error_sum(0),
      pre_error(0) {}

float Integrator::Update(float error)
{
    // Euler method
    // error_sum += error * control_period;

    // Bilinear transform
    error_sum += (error + pre_error) * control_period * 0.5;
    pre_error = error;
    if (error_sum > bound_windup)
        error_sum = bound_windup;
    else if (error_sum < -bound_windup)
        error_sum = -bound_windup;

    return error_sum;
}

void Integrator::ResetIntegrator()
{
    error_sum = 0.0;
    pre_error = 0.0;
}

Differentiator::Differentiator(float tf, float control_period)
    : tf(tf),
      control_period(control_period),
      coeff(tf / (tf + control_period)),
      deriv(0),
      pre_error(0),
      pre_deriv(0) {}

float Differentiator::Update(float error)
{
    // Euler method
    // float deriv = (error - pre_error) / control_period;

    // Bilinear transform
    deriv = (error - pre_error) * 2.0f / control_period - pre_deriv;

    // Low pass Filter (first order)
    pre_deriv = coeff * pre_deriv + (1.0f - coeff) * deriv;
    pre_error = error;
    return pre_deriv;
}

void Differentiator::ResetDifferentiator()
{
    pre_error = 0.0;
    pre_deriv = 0.0;
}

PID::PID(float kp, float ki, float kd, float tf, float control_period, float bound_windup)
    : kp(kp),
      ki(ki),
      kd(kd),
      integrator(control_period, bound_windup),
      differentiator(tf, control_period) {}

float PID::Update(float error)
{
    this->error = error;
    sum = integrator.Update(error);
    deriv = differentiator.Update(error);
    input = kp * error + ki * sum + kd * deriv;
    return input;
}

void PID::Reset()
{
    integrator.ResetIntegrator();
    differentiator.ResetDifferentiator();
}

void PID::OutputLog()
{
    printf("%.3f, %.3f\n", error, input);
}
