Teruru-52/Cubli/firmware/motor_driver/Core/Src/gpio.c

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

/* Includes ------------------------------------------------------------------*/
#include "gpio.h"

/* USER CODE BEGIN 0 */
GPIO_Value LED_WHITE = {LED1_GPIO_Port, LED1_Pin};
GPIO_Value LED_BLUE = {LED2_GPIO_Port, LED2_Pin};
GPIO_Value LED_YELLOW = {LED3_GPIO_Port, LED3_Pin};
GPIO_Value LED_RED = {LED4_GPIO_Port, LED4_Pin};
GPIO_Value LED_CAN_TX = {LED_CAN_TX_GPIO_Port, LED_CAN_TX_Pin};
GPIO_Value LED_CAN_RX = {LED_CAN_RX_GPIO_Port, LED_CAN_RX_Pin};

GPIO_Value USER_SW = {SW_GPIO_Port, SW_Pin};
GPIO_Value SPI1_CS_DRV = {SPI_CS_DRV_GPIO_Port, SPI_CS_DRV_Pin};
GPIO_Value SPI2_CS_ENC = {SPI_CS_ENC_GPIO_Port, SPI_CS_ENC_Pin};

GPIO_Value HALL_U = {Hall_U_GPIO_Port, Hall_U_Pin};
GPIO_Value HALL_V = {Hall_V_GPIO_Port, Hall_V_Pin};
GPIO_Value HALL_W = {Hall_W_GPIO_Port, Hall_W_Pin};

GPIO_Value DRV_nFAULT = {nFAULT_GPIO_Port, nFAULT_Pin};
GPIO_Value DRV_ENABLE = {ENABLE_GPIO_Port, ENABLE_Pin};
GPIO_Value DRV_CAL = {CAL_GPIO_Port, CAL_Pin};
GPIO_Value DRV_INLA = {INLA_GPIO_Port, INLA_Pin};
GPIO_Value DRV_INLB = {INLB_GPIO_Port, INLB_Pin};
GPIO_Value DRV_INLC = {INLC_GPIO_Port, INLC_Pin};

Access_Lamp BLMD_Access_Lamp = {DISABLE, DISABLE};
/* USER CODE END 0 */

/*----------------------------------------------------------------------------*/
/* Configure GPIO                                                             */
/*----------------------------------------------------------------------------*/
/** Configure pins as
        * Analog
        * Input
        * Output
        * EVENT_OUT
        * EXTI
*/
void MX_GPIO_Init(void)
{

  GPIO_InitTypeDef GPIO_InitStruct = {0};

  /* GPIO Ports Clock Enable */
  __HAL_RCC_GPIOC_CLK_ENABLE();
  __HAL_RCC_GPIOF_CLK_ENABLE();
  __HAL_RCC_GPIOA_CLK_ENABLE();
  __HAL_RCC_GPIOB_CLK_ENABLE();

  /*Configure GPIO pin Output Level */
  HAL_GPIO_WritePin(GPIOC, INLC_Pin|INLB_Pin|INLA_Pin, GPIO_PIN_RESET);

  /*Configure GPIO pin Output Level */
  HAL_GPIO_WritePin(GPIOA, CAL_Pin|ENABLE_Pin|LED_CAN_TX_Pin|LED_CAN_RX_Pin, GPIO_PIN_RESET);

  /*Configure GPIO pin Output Level */
  HAL_GPIO_WritePin(GPIOB, SPI_CS_DRV_Pin|LED1_Pin|LED2_Pin|LED3_Pin
                          |LED4_Pin|SPI_CS_ENC_Pin, GPIO_PIN_RESET);

  /*Configure GPIO pins : PCPin PCPin PCPin */
  GPIO_InitStruct.Pin = INLC_Pin|INLB_Pin|INLA_Pin;
  GPIO_InitStruct.Mode = GPIO_MODE_OUTPUT_PP;
  GPIO_InitStruct.Pull = GPIO_NOPULL;
  GPIO_InitStruct.Speed = GPIO_SPEED_FREQ_LOW;
  HAL_GPIO_Init(GPIOC, &GPIO_InitStruct);

  /*Configure GPIO pins : PAPin PAPin PAPin PAPin */
  GPIO_InitStruct.Pin = CAL_Pin|ENABLE_Pin|LED_CAN_TX_Pin|LED_CAN_RX_Pin;
  GPIO_InitStruct.Mode = GPIO_MODE_OUTPUT_PP;
  GPIO_InitStruct.Pull = GPIO_NOPULL;
  GPIO_InitStruct.Speed = GPIO_SPEED_FREQ_LOW;
  HAL_GPIO_Init(GPIOA, &GPIO_InitStruct);

  /*Configure GPIO pins : PBPin PBPin PBPin PBPin
                           PBPin */
  GPIO_InitStruct.Pin = SPI_CS_DRV_Pin|LED1_Pin|LED2_Pin|LED3_Pin
                          |LED4_Pin;
  GPIO_InitStruct.Mode = GPIO_MODE_OUTPUT_PP;
  GPIO_InitStruct.Pull = GPIO_NOPULL;
  GPIO_InitStruct.Speed = GPIO_SPEED_FREQ_LOW;
  HAL_GPIO_Init(GPIOB, &GPIO_InitStruct);

  /*Configure GPIO pin : PtPin */
  GPIO_InitStruct.Pin = nFAULT_Pin;
  GPIO_InitStruct.Mode = GPIO_MODE_INPUT;
  GPIO_InitStruct.Pull = GPIO_PULLUP;
  HAL_GPIO_Init(nFAULT_GPIO_Port, &GPIO_InitStruct);

  /*Configure GPIO pin : PtPin */
  GPIO_InitStruct.Pin = SW_Pin;
  GPIO_InitStruct.Mode = GPIO_MODE_INPUT;
  GPIO_InitStruct.Pull = GPIO_NOPULL;
  HAL_GPIO_Init(SW_GPIO_Port, &GPIO_InitStruct);

  /*Configure GPIO pin : PtPin */
  GPIO_InitStruct.Pin = Hall_W_Pin;
  GPIO_InitStruct.Mode = GPIO_MODE_IT_RISING_FALLING;
  GPIO_InitStruct.Pull = GPIO_NOPULL;
  HAL_GPIO_Init(Hall_W_GPIO_Port, &GPIO_InitStruct);

  /*Configure GPIO pins : PBPin PBPin */
  GPIO_InitStruct.Pin = Hall_U_Pin|Hall_V_Pin;
  GPIO_InitStruct.Mode = GPIO_MODE_IT_RISING_FALLING;
  GPIO_InitStruct.Pull = GPIO_NOPULL;
  HAL_GPIO_Init(GPIOB, &GPIO_InitStruct);

  /*Configure GPIO pin : PtPin */
  GPIO_InitStruct.Pin = SPI_CS_ENC_Pin;
  GPIO_InitStruct.Mode = GPIO_MODE_OUTPUT_PP;
  GPIO_InitStruct.Pull = GPIO_PULLUP;
  GPIO_InitStruct.Speed = GPIO_SPEED_FREQ_LOW;
  HAL_GPIO_Init(SPI_CS_ENC_GPIO_Port, &GPIO_InitStruct);

  /* EXTI interrupt init*/
  HAL_NVIC_SetPriority(EXTI3_IRQn, 5, 0);
  HAL_NVIC_EnableIRQ(EXTI3_IRQn);

  HAL_NVIC_SetPriority(EXTI4_IRQn, 5, 0);
  HAL_NVIC_EnableIRQ(EXTI4_IRQn);

  HAL_NVIC_SetPriority(EXTI15_10_IRQn, 5, 0);
  HAL_NVIC_EnableIRQ(EXTI15_10_IRQn);

}

/* USER CODE BEGIN 2 */
GPIO_PinState Read_GPIO(GPIO_Value GPIO)
{
  return HAL_GPIO_ReadPin(GPIO.GPIOx, GPIO.GPIO_PIN_x);
}

void Toggle_GPIO(GPIO_Value GPIO)
{
  HAL_GPIO_TogglePin(GPIO.GPIOx, GPIO.GPIO_PIN_x);
}

void Write_GPIO(GPIO_Value GPIO, GPIO_PinState PinState)
{
  HAL_GPIO_WritePin(GPIO.GPIOx, GPIO.GPIO_PIN_x, PinState);
}

void SetTxLED(GPIO_PinState PinState)
{
  Write_GPIO(LED_CAN_TX, PinState);
}

void ActivateTxLED(void)
{
  if (BLMD_Access_Lamp.FDCAN_TX == ENABLE)
  {
    Write_GPIO(LED_CAN_TX, GPIO_PIN_SET);
  }
}

void ResetTxLED(void)
{
  BLMD_Access_Lamp.FDCAN_TX = DISABLE;
}

void SetRxLED(GPIO_PinState PinState)
{
  Write_GPIO(LED_CAN_RX, PinState);
}

void ActivateRxLED(void)
{
  if (BLMD_Access_Lamp.FDCAN_RX == ENABLE)
  {
    Write_GPIO(LED_CAN_RX, GPIO_PIN_SET);
  }
}

void ResetRxLED(void)
{
  BLMD_Access_Lamp.FDCAN_RX = DISABLE;
}
/* USER CODE END 2 */
