Teruru-52/Cubli/firmware/motor_driver/Application/Inc/main_exec.h

/*
 * main_exec.h
 *
 *  Created on: Aug 15th, 2023
 *      Author: Reiji Terunuma
 */

#ifndef MAIN_EXEC_H_
#define MAIN_EXEC_H_

#ifdef __cplusplus
extern "C"
{
#endif
#include "main.h"

    void InitializeDriver();
    void TIMUpdate();
    void ADCCpltCallback();
    void FDCANReceiveCallback(uint8_t *pRxData);
    void LogPrint();

    void TestHallSensor();
    void TestEncoder();
    void TestElectricAngle();

#ifdef __cplusplus
};
#endif

extern bool can_received;
extern uint32_t can_receive_interval;

extern uint8_t TxData[8];

void LEDUpdate(void);

#endif // MAIN_EXEC_H_
