Teruru-52/Cubli/firmware/main_board/Core/Src/spi.c

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
/* Includes ------------------------------------------------------------------*/
#include "spi.h"

SPI_HandleTypeDef hspi1;
SPI_HandleTypeDef hspi2;

/* SPI1 init function */
void MX_SPI1_Init(void)
{

  hspi1.Instance = SPI1;
  hspi1.Init.Mode = SPI_MODE_MASTER;
  hspi1.Init.Direction = SPI_DIRECTION_1LINE;
  hspi1.Init.DataSize = SPI_DATASIZE_8BIT;
  hspi1.Init.CLKPolarity = SPI_POLARITY_LOW;
  hspi1.Init.CLKPhase = SPI_PHASE_1EDGE;
  hspi1.Init.NSS = SPI_NSS_SOFT;
  hspi1.Init.BaudRatePrescaler = SPI_BAUDRATEPRESCALER_32;
  hspi1.Init.FirstBit = SPI_FIRSTBIT_MSB;
  hspi1.Init.TIMode = SPI_TIMODE_DISABLE;
  hspi1.Init.CRCCalculation = SPI_CRCCALCULATION_DISABLE;
  hspi1.Init.CRCPolynomial = 10;
  if (HAL_SPI_Init(&hspi1) != HAL_OK)
  {
    Error_Handler();
  }
}
/* SPI2 init function */
void MX_SPI2_Init(void)
{

  hspi2.Instance = SPI2;
  hspi2.Init.Mode = SPI_MODE_MASTER;
  hspi2.Init.Direction = SPI_DIRECTION_2LINES;
  hspi2.Init.DataSize = SPI_DATASIZE_8BIT;
  hspi2.Init.CLKPolarity = SPI_POLARITY_HIGH;
  hspi2.Init.CLKPhase = SPI_PHASE_2EDGE;
  hspi2.Init.NSS = SPI_NSS_SOFT;
  hspi2.Init.BaudRatePrescaler = SPI_BAUDRATEPRESCALER_64;
  hspi2.Init.FirstBit = SPI_FIRSTBIT_MSB;
  hspi2.Init.TIMode = SPI_TIMODE_DISABLE;
  hspi2.Init.CRCCalculation = SPI_CRCCALCULATION_DISABLE;
  hspi2.Init.CRCPolynomial = 10;
  if (HAL_SPI_Init(&hspi2) != HAL_OK)
  {
    Error_Handler();
  }
}

void HAL_SPI_MspInit(SPI_HandleTypeDef* spiHandle)
{

  GPIO_InitTypeDef GPIO_InitStruct = {0};
  if(spiHandle->Instance==SPI1)
  {
    /* SPI1 clock enable */
    __HAL_RCC_SPI1_CLK_ENABLE();

    __HAL_RCC_GPIOA_CLK_ENABLE();
    /**SPI1 GPIO Configuration
    PA5     ------> SPI1_SCK
    PA7     ------> SPI1_MOSI
    */
    GPIO_InitStruct.Pin = GPIO_PIN_5|GPIO_PIN_7;
    GPIO_InitStruct.Mode = GPIO_MODE_AF_PP;
    GPIO_InitStruct.Pull = GPIO_NOPULL;
    GPIO_InitStruct.Speed = GPIO_SPEED_FREQ_VERY_HIGH;
    GPIO_InitStruct.Alternate = GPIO_AF5_SPI1;
    HAL_GPIO_Init(GPIOA, &GPIO_InitStruct);

  }
  else if(spiHandle->Instance==SPI2)
  {
    /* SPI2 clock enable */
    __HAL_RCC_SPI2_CLK_ENABLE();

    __HAL_RCC_GPIOC_CLK_ENABLE();
    __HAL_RCC_GPIOB_CLK_ENABLE();
    /**SPI2 GPIO Configuration
    PC2     ------> SPI2_MISO
    PC3     ------> SPI2_MOSI
    PB13     ------> SPI2_SCK
    */
    GPIO_InitStruct.Pin = GPIO_PIN_2|GPIO_PIN_3;
    GPIO_InitStruct.Mode = GPIO_MODE_AF_PP;
    GPIO_InitStruct.Pull = GPIO_NOPULL;
    GPIO_InitStruct.Speed = GPIO_SPEED_FREQ_VERY_HIGH;
    GPIO_InitStruct.Alternate = GPIO_AF5_SPI2;
    HAL_GPIO_Init(GPIOC, &GPIO_InitStruct);

    GPIO_InitStruct.Pin = GPIO_PIN_13;
    GPIO_InitStruct.Mode = GPIO_MODE_AF_PP;
    GPIO_InitStruct.Pull = GPIO_NOPULL;
    GPIO_InitStruct.Speed = GPIO_SPEED_FREQ_VERY_HIGH;
    GPIO_InitStruct.Alternate = GPIO_AF5_SPI2;
    HAL_GPIO_Init(GPIOB, &GPIO_InitStruct);

  }
}

void HAL_SPI_MspDeInit(SPI_HandleTypeDef* spiHandle)
{

  if(spiHandle->Instance==SPI1)
  {
    /* Peripheral clock disable */
    __HAL_RCC_SPI1_CLK_DISABLE();

    /**SPI1 GPIO Configuration
    PA5     ------> SPI1_SCK
    PA7     ------> SPI1_MOSI
    */
    HAL_GPIO_DeInit(GPIOA, GPIO_PIN_5|GPIO_PIN_7);

  }
  else if(spiHandle->Instance==SPI2)
  {
    /* Peripheral clock disable */
    __HAL_RCC_SPI2_CLK_DISABLE();

    /**SPI2 GPIO Configuration
    PC2     ------> SPI2_MISO
    PC3     ------> SPI2_MOSI
    PB13     ------> SPI2_SCK
    */
    HAL_GPIO_DeInit(GPIOC, GPIO_PIN_2|GPIO_PIN_3);

    HAL_GPIO_DeInit(GPIOB, GPIO_PIN_13);

  }
}

/* USER CODE BEGIN 1 */
SPI_Value spi_imu1 = {&hspi2, &SPI_CS_IMU1, 2, 10};
SPI_Value spi_imu2 = {&hspi2, &SPI_CS_IMU2, 2, 10};
SPI_Value spi_imu3 = {&hspi2, &SPI_CS_IMU3, 2, 10};
SPI_Value spi_imu4 = {&hspi2, &SPI_CS_IMU4, 2, 10};
SPI_Value spi_imu5 = {&hspi2, &SPI_CS_IMU5, 2, 10};
SPI_Value spi_imu6 = {&hspi2, &SPI_CS_IMU6, 2, 10};

uint8_t Read_1byte(SPI_Value *spi_value, uint8_t reg)
{
  uint8_t rx_data[2];
  uint8_t tx_data[2];

  tx_data[0] = reg | 0x80;
  tx_data[1] = 0x00; // dummy

  Write_GPIO(*(spi_value->SPI_CS), GPIO_PIN_RESET);
  HAL_SPI_TransmitReceive(spi_value->hspi, tx_data, rx_data, spi_value->size, spi_value->timeout);
  Write_GPIO(*(spi_value->SPI_CS), GPIO_PIN_SET);

  return rx_data[1];
}

void Write_1byte(SPI_Value *spi_value, uint8_t reg, uint8_t data)
{
  uint8_t rx_data[2];
  uint8_t tx_data[2];

  tx_data[0] = reg & 0x7F;
  tx_data[1] = data; // write data

  Write_GPIO(*(spi_value->SPI_CS), GPIO_PIN_RESET);
  HAL_SPI_TransmitReceive(spi_value->hspi, tx_data, rx_data, spi_value->size, spi_value->timeout);
  Write_GPIO(*(spi_value->SPI_CS), GPIO_PIN_SET);
}

void Reset_CS_Pin()
{
  Write_GPIO(SPI_CS_IMU1, GPIO_PIN_SET);
  Write_GPIO(SPI_CS_IMU2, GPIO_PIN_SET);
  Write_GPIO(SPI_CS_IMU3, GPIO_PIN_SET);
  Write_GPIO(SPI_CS_IMU4, GPIO_PIN_SET);
  Write_GPIO(SPI_CS_IMU5, GPIO_PIN_SET);
  Write_GPIO(SPI_CS_IMU6, GPIO_PIN_SET);

  Write_GPIO(SPI_CS_LCD, GPIO_PIN_SET);
}
/* USER CODE END 1 */
