Teruru-52/Cubli/firmware/main_board/Core/Src/can.c

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
/* Includes ------------------------------------------------------------------*/
#include "can.h"

/* USER CODE BEGIN 0 */
extern void CANReceiveCallback(uint8_t *pRxData);
/* USER CODE END 0 */

CAN_HandleTypeDef hcan1;

/* CAN1 init function */
void MX_CAN1_Init(void)
{

  hcan1.Instance = CAN1;
  hcan1.Init.Prescaler = 6;
  hcan1.Init.Mode = CAN_MODE_NORMAL;
  hcan1.Init.SyncJumpWidth = CAN_SJW_1TQ;
  hcan1.Init.TimeSeg1 = CAN_BS1_11TQ;
  hcan1.Init.TimeSeg2 = CAN_BS2_2TQ;
  hcan1.Init.TimeTriggeredMode = ENABLE;
  hcan1.Init.AutoBusOff = ENABLE;
  hcan1.Init.AutoWakeUp = ENABLE;
  hcan1.Init.AutoRetransmission = DISABLE;
  hcan1.Init.ReceiveFifoLocked = ENABLE;
  hcan1.Init.TransmitFifoPriority = ENABLE;
  if (HAL_CAN_Init(&hcan1) != HAL_OK)
  {
    Error_Handler();
  }
  /* USER CODE BEGIN CAN1_Init 2 */
  CAN_FilterTypeDef sFilterConfig;
  sFilterConfig.FilterBank = 0;
  sFilterConfig.FilterMode = CAN_FILTERMODE_IDLIST;
  sFilterConfig.FilterScale = CAN_FILTERSCALE_16BIT;

  // BLMD
  sFilterConfig.FilterIdHigh = CAN_ID_MD1 << 5;
  sFilterConfig.FilterIdLow = CAN_ID_MD1 << 5;
  sFilterConfig.FilterMaskIdHigh = CAN_ID_MD1 << 5;
  sFilterConfig.FilterMaskIdLow = CAN_ID_MD1 << 5;

  // sFilterConfig.FilterFIFOAssignment = CAN_RX_FIFO0;
  sFilterConfig.FilterFIFOAssignment = CAN_FILTER_FIFO0;
  sFilterConfig.FilterActivation = ENABLE;

  sFilterConfig.SlaveStartFilterBank = 14;

  if (HAL_CAN_ConfigFilter(&hcan1, &sFilterConfig) != HAL_OK)
  {
    Error_Handler();
  }
  HAL_CAN_Start(&hcan1);
  if (HAL_CAN_ActivateNotification(&hcan1, CAN_IT_RX_FIFO0_MSG_PENDING) != HAL_OK)
  {
    Error_Handler();
  }
  if (HAL_CAN_ActivateNotification(&hcan1, CAN_IT_TX_MAILBOX_EMPTY) != HAL_OK)
  {
    Error_Handler();
  }
  /* USER CODE END CAN1_Init 2 */
}

void HAL_CAN_MspInit(CAN_HandleTypeDef *canHandle)
{

  GPIO_InitTypeDef GPIO_InitStruct = {0};
  if (canHandle->Instance == CAN1)
  {
    /* CAN1 clock enable */
    __HAL_RCC_CAN1_CLK_ENABLE();

    __HAL_RCC_GPIOA_CLK_ENABLE();
    /**CAN1 GPIO Configuration
    PA11     ------> CAN1_RX
    PA12     ------> CAN1_TX
    */
    GPIO_InitStruct.Pin = GPIO_PIN_11 | GPIO_PIN_12;
    GPIO_InitStruct.Mode = GPIO_MODE_AF_PP;
    GPIO_InitStruct.Pull = GPIO_NOPULL;
    GPIO_InitStruct.Speed = GPIO_SPEED_FREQ_VERY_HIGH;
    GPIO_InitStruct.Alternate = GPIO_AF9_CAN1;
    HAL_GPIO_Init(GPIOA, &GPIO_InitStruct);

    /* CAN1 interrupt Init */
    HAL_NVIC_SetPriority(CAN1_RX0_IRQn, 5, 0);
    HAL_NVIC_EnableIRQ(CAN1_RX0_IRQn);
  }
}

void HAL_CAN_MspDeInit(CAN_HandleTypeDef *canHandle)
{

  if (canHandle->Instance == CAN1)
  {
    /* Peripheral clock disable */
    __HAL_RCC_CAN1_CLK_DISABLE();

    /**CAN1 GPIO Configuration
    PA11     ------> CAN1_RX
    PA12     ------> CAN1_TX
    */
    HAL_GPIO_DeInit(GPIOA, GPIO_PIN_11 | GPIO_PIN_12);

    /* CAN1 interrupt Deinit */
    HAL_NVIC_DisableIRQ(CAN1_RX0_IRQn);
  }
}

/* USER CODE BEGIN 1 */
void HAL_CAN_RxFifo0MsgPendingCallback(CAN_HandleTypeDef *hcan)
{
  if (HAL_CAN_GetRxMessage(hcan, CAN_RX_FIFO0, &RxHeader, RxData) != HAL_OK)
  {
    Error_Handler();
  }
  // printf("id=%ld, data=%d\r\n", RxHeader.StdId, RxData[0]);
  CANReceiveCallback(RxData);
}
/* USER CODE END 1 */
