Teruru-52/Cubli/firmware/motor_driver/Core/Inc/tim.h

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
/* Define to prevent recursive inclusion -------------------------------------*/
#ifndef __TIM_H__
#define __TIM_H__

#ifdef __cplusplus
extern "C" {
#endif

/* Includes ------------------------------------------------------------------*/
#include "main.h"

extern TIM_HandleTypeDef htim1;

extern TIM_HandleTypeDef htim3;

extern TIM_HandleTypeDef htim4;

/* USER CODE BEGIN Private defines */
#define TIM_CLOCK_DIVIDER 1
#define ADV_TIM_CLK_MHz 168
#define PWM_FREQUENCY 30000
#define PWM_PERIOD_CYCLES (uint16_t)(ADV_TIM_CLK_MHz * \
                                     (uint32_t)1000000u / ((uint32_t)(PWM_FREQUENCY)))
/* USER CODE END Private defines */

void MX_TIM1_Init(void);
void MX_TIM3_Init(void);
void MX_TIM4_Init(void);

void HAL_TIM_MspPostInit(TIM_HandleTypeDef *htim);

/* USER CODE BEGIN Prototypes */
  typedef struct _BLDC_PWM
  {
    TIM_HandleTypeDef *htim;
    uint32_t Channel_U;
    uint32_t Channel_V;
    uint32_t Channel_W;
  } BLDC_PWM;

  void Blmd_TIM_Init(void);
  void _configure3PWM(BLDC_PWM *bldc_pwm);
  void _writeDutyCycle3PWM(BLDC_PWM *bldc_pwm, float duty_u, float duty_v, float duty_w);

  extern BLDC_PWM blcd_pwm;
/* USER CODE END Prototypes */

#ifdef __cplusplus
}
#endif

#endif /* __TIM_H__ */
