Teruru-52/Cubli/firmware/motor_driver/Core/Src/app_freertos.c

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

/* Includes ------------------------------------------------------------------*/
#include "FreeRTOS.h"
#include "task.h"
#include "main.h"
#include "cmsis_os.h"

/* USER CODE BEGIN Includes */
#include "main_exec.h"
/* USER CODE END Includes */

osThreadId defaultTaskHandle;
osThreadId LEDTaskHandle;

void StartDefaultTask(void const * argument);
void StartLEDTask(void const * argument);

void MX_FREERTOS_Init(void); /* (MISRA C 2004 rule 8.1) */

/**
  * @brief  FreeRTOS initialization
  * @param  None
  * @retval None
  */
void MX_FREERTOS_Init(void) {
  /* USER CODE BEGIN RTOS_MUTEX */
  /* add mutexes, ... */
  /* USER CODE END RTOS_MUTEX */

  /* USER CODE BEGIN RTOS_SEMAPHORES */
  /* add semaphores, ... */
  /* USER CODE END RTOS_SEMAPHORES */

  /* USER CODE BEGIN RTOS_TIMERS */
  /* start timers, add new ones, ... */
  /* USER CODE END RTOS_TIMERS */

  /* USER CODE BEGIN RTOS_QUEUES */
  /* add queues, ... */
  /* USER CODE END RTOS_QUEUES */

  /* Create the thread(s) */
  /* definition and creation of defaultTask */
  osThreadDef(defaultTask, StartDefaultTask, osPriorityNormal, 0, 128);
  defaultTaskHandle = osThreadCreate(osThread(defaultTask), NULL);

  /* definition and creation of LEDTask */
  osThreadDef(LEDTask, StartLEDTask, osPriorityNormal, 0, 128);
  LEDTaskHandle = osThreadCreate(osThread(LEDTask), NULL);

  /* USER CODE BEGIN RTOS_THREADS */
  /* add threads, ... */
  /* USER CODE END RTOS_THREADS */

}

/* USER CODE BEGIN Header_StartDefaultTask */
/**
 * @brief  Function implementing the defaultTask thread.
 * @param  argument: Not used
 * @retval None
 */
/* USER CODE END Header_StartDefaultTask */
void StartDefaultTask(void const * argument)
{
  /* USER CODE BEGIN StartDefaultTask */
  /* Infinite loop */
  for (;;)
  {
  }
  /* USER CODE END StartDefaultTask */
}

/* USER CODE BEGIN Header_StartLEDTask */
/**
 * @brief Function implementing the LEDTask thread.
 * @param argument: Not used
 * @retval None
 */
/* USER CODE END Header_StartLEDTask */
void StartLEDTask(void const * argument)
{
  /* USER CODE BEGIN StartLEDTask */
  /* Infinite loop */
  for (;;)
  {
    ActivateTxLED();
    ResetTxLED();
    osDelay(100);
    SetTxLED(GPIO_PIN_RESET);

    ActivateRxLED();
    ResetRxLED();
    osDelay(100);
    SetRxLED(GPIO_PIN_RESET);
  }
  /* USER CODE END StartLEDTask */
}
