Teruru-52/Cubli/firmware/motor_driver/Core/Inc/gpio.h

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
/* Define to prevent recursive inclusion -------------------------------------*/
#ifndef __GPIO_H__
#define __GPIO_H__

#ifdef __cplusplus
extern "C" {
#endif

/* Includes ------------------------------------------------------------------*/
#include "main.h"

/* USER CODE BEGIN Private defines */
  typedef struct _GPIO_Value
  {
    GPIO_TypeDef *GPIOx;
    uint16_t GPIO_PIN_x;
  } GPIO_Value;

  extern GPIO_Value LED_WHITE;
  extern GPIO_Value LED_BLUE;
  extern GPIO_Value LED_YELLOW;
  extern GPIO_Value LED_RED;
  extern GPIO_Value LED_CAN_TX;
  extern GPIO_Value LED_CAN_RX;

  extern GPIO_Value USER_SW;
  extern GPIO_Value SPI1_CS_DRV;
  extern GPIO_Value SPI2_CS_ENC;

  extern GPIO_Value HALL_U;
  extern GPIO_Value HALL_V;
  extern GPIO_Value HALL_W;

  extern GPIO_Value DRV_nFAULT;
  extern GPIO_Value DRV_ENABLE;
  extern GPIO_Value DRV_CAL;
  extern GPIO_Value DRV_INLA;
  extern GPIO_Value DRV_INLB;
  extern GPIO_Value DRV_INLC;

  typedef struct _Access_Lamp
  {
    FunctionalState FDCAN_TX;
    FunctionalState FDCAN_RX;
  } Access_Lamp;

  extern Access_Lamp BLMD_Access_Lamp;
/* USER CODE END Private defines */

void MX_GPIO_Init(void);

/* USER CODE BEGIN Prototypes */
  GPIO_PinState Read_GPIO(GPIO_Value GPIO);
  void Toggle_GPIO(GPIO_Value GPIO);
  void Write_GPIO(GPIO_Value GPIO, GPIO_PinState PinState);

  void SetTxLED(GPIO_PinState PinState);
  void ActivateTxLED(void);
  void ResetTxLED(void);

  void SetRxLED(GPIO_PinState PinState);
  void ActivateRxLED(void);
  void ResetRxLED(void);
/* USER CODE END Prototypes */

#ifdef __cplusplus
}
#endif
#endif /*__ GPIO_H__ */
