Teruru-52/Cubli/firmware/main_board/Application/Inc/instance.h

/*
 * instance.h
 *
 *  Created on: Aug 13th, 2023
 *      Author: Reiji Terunuma
 */

#ifndef INSTANCE_H_
#define INSTANCE_H_

#include "main.h"
#include "controller/controller.h"
#include "controller/state.h"

extern StateBase *state;
extern ControllerBase *controller;

#endif // INSTANCE_H_
