Teruru-52/Cubli/firmware/motor_driver/Application/Inc/instance.h

/*
 * instance.h
 *
 *  Created on: Aug 15th, 2023
 *      Author: Reiji Terunuma
 */

#ifndef INSTANCE_H_
#define INSTANCE_H_

#include "main.h"
#include "driver_controller.h"

extern DRV8323 drv;
extern HallSensor hall;
extern A1333 encoder;

extern VelocityDriver velocity_driver;
extern TorqueDriver torque_driver;
extern DriverControllerBase *driver_controller;

#endif // INSTANCE_H_
