Teruru-52/Cubli/(commit log)

2023-08-14 update pcb
    [drv8323.kicad_sch, imu.kicad_pcb, imu.kicad_sch, imu_board.dxf, motor_driver.kicad_pcb, motor_driver.kicad_sch, power.kicad_sch, stm32g431cb.kicad_sch]
2023-08-14 add blmd dxf
    [blmd.dxf]
2023-08-15 add calculation of angular velocity
2023-08-15 add dxf
    [blmd2.dxf]
2023-10-04 chore: add circuit git changes
    [can.kicad_sch, can_connector.kicad_sch, drv8323.kicad_sch, imu.kicad_sch, imu_connector.kicad_sch, lcd.dxf, main.kicad_pcb, main.kicad_sch]
2023-10-04 feat: calculate sensor position
2023-10-08 chore: add pcb backups
2023-10-08 feat: add functions (CAN, sensors, FreeRTOS)
2023-10-08 fix: imu potision
2023-10-08 feat: add functions (CAN, IMU)
2023-10-26 feat: add GPIO Interruption
2023-10-26 fix: remove GPIO Interruption
    [app_freertos.c, gpio.c, hall_sensor.cpp, hall_sensor.h, main.h, main_exec.cpp, motor_driver.ioc]
2023-11-05 chore: try to fix bug
    [drv8323.cpp, gpio.c, main.c, main_exec.cpp, main_exec.h, motor_driver.ioc]
2024-01-12 feat: fix most bug
    [drv8323.kicad_sch, motor_driver.kicad_pcb, motor_driver.kicad_sch, stm32g431cb.kicad_sch]
2024-05-18 chore: commit before starting to develop v1.2
    [drv8323.kicad_sch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]
2024-05-18 chore: add v1.2
    [can.kicad_sch, can_connector.kicad_sch, com.kicad_sch, drv8323.kicad_sch, half_bridge.kicad_sch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]
2024-06-11 perf: fix pcb for v1.2
    [drv8323.kicad_sch, motor_driver.kicad_pcb, motor_driver.kicad_sch, power.kicad_sch, stm32g431cb.kicad_sch]
2024-06-11 feat: finish adding a connector
    [pdb.kicad_pcb, pdb.kicad_sch]
2024-07-26 feat: finish main board v2
    [can.kicad_sch, imu.kicad_sch, imu_connector.kicad_sch, main.kicad_pcb, main.kicad_sch, power.kicad_sch, stm32f405rg.kicad_sch]
2024-08-02 perf: update motor driver pdb
    [drv8323.kicad_sch, motor_driver.kicad_pcb, motor_driver.kicad_sch, power.kicad_sch, stm32g431cb.kicad_sch]
2024-08-02 perf: edit SW footprint
    [main.kicad_pcb, stm32f405rg.kicad_sch]
2024-08-03 wip: can settings
    [motor_driver.kicad_pcb]
2024-08-09 feat: delete two CAN connectors & add microSD input pin
    [can.kicad_sch, main.kicad_pcb, main.kicad_sch, power.kicad_sch, stm32f405rg.kicad_sch]
2024-08-09 feat: add additional CAN connetctor
    [drv8323.kicad_sch, motor_driver.kicad_pcb, power.kicad_sch, stm32g431cb.kicad_sch]
2024-08-09 feat: add DC jack & change XT30 footprint
    [pdb.kicad_pcb, pdb.kicad_sch]
2024-08-14 chore: add gerber
    [main-B_Cu.gbl, main-B_Mask.gbs, main-B_Paste.gbp, main-B_Silkscreen.gbo, main-Edge_Cuts.gm1, main-F_Cu.gtl, main-F_Mask.gts, main-F_Paste.gtp]
2024-09-03 chore: add pcb backup
2024-09-19 feat: enable to turn on LEDs
2024-09-20 chore(wip): check LEDs
2024-09-21 feat: update encoder
2024-09-22 feat: dma for current sense
2024-09-22 feat: spi & inject transform
2024-09-23 fix: spi2 (encoder) config
    [adc.c, driver_controller.cpp, encoder.cpp, encoder.h, main.c, motor_driver.ioc, spi.c, spi.h]
